Renanuya/optik-platform/drawings/sayfa-01.png

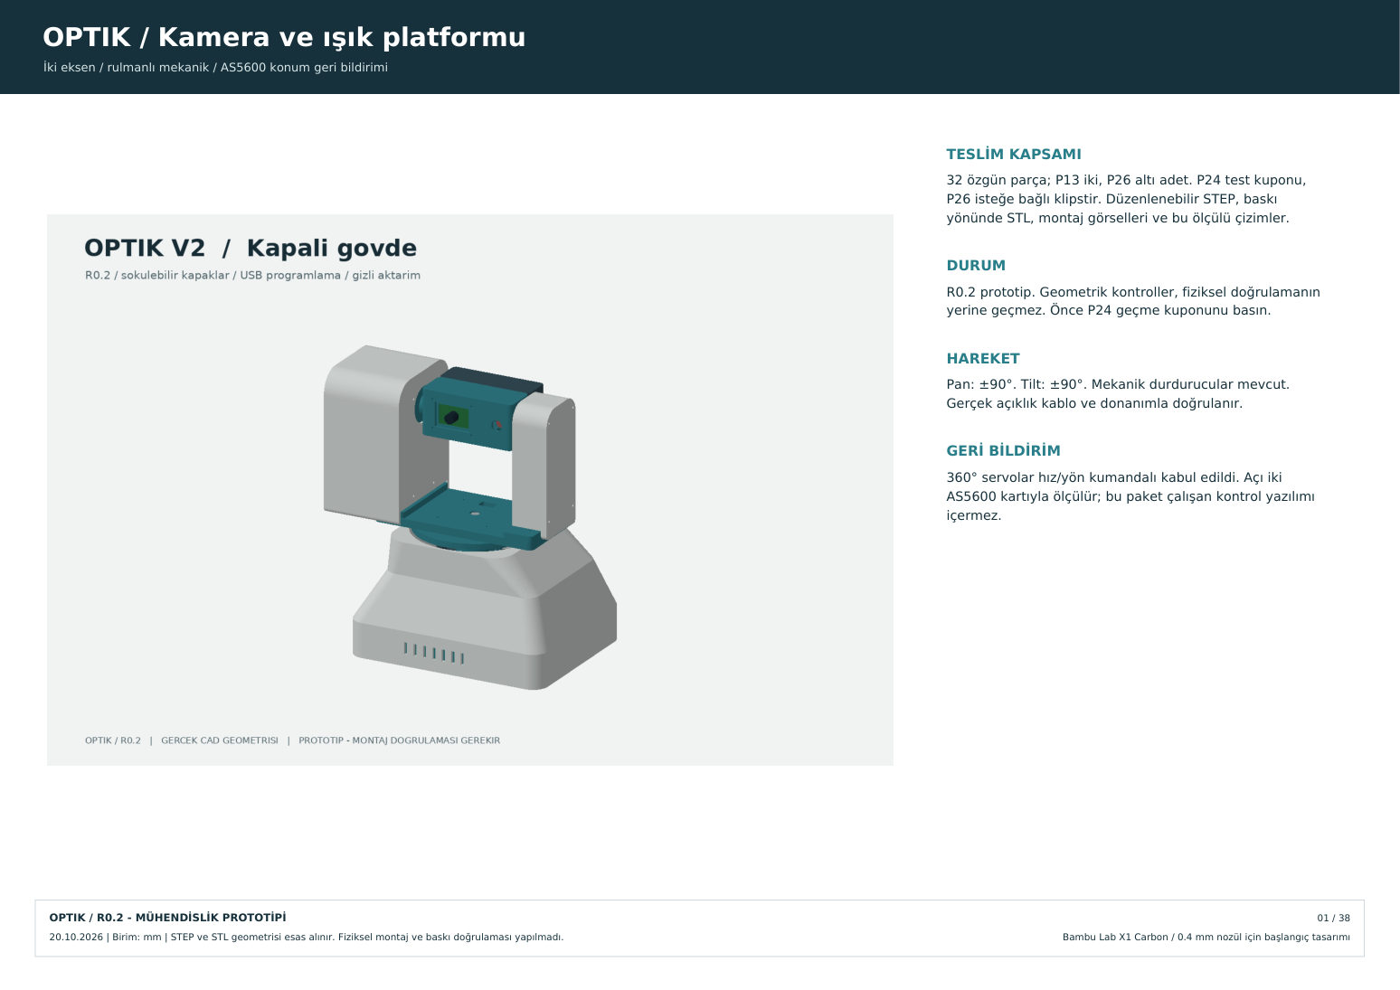
drawings/sayfa-01.png
