Renanuya/optik-platform/drawings/sayfa-02.png

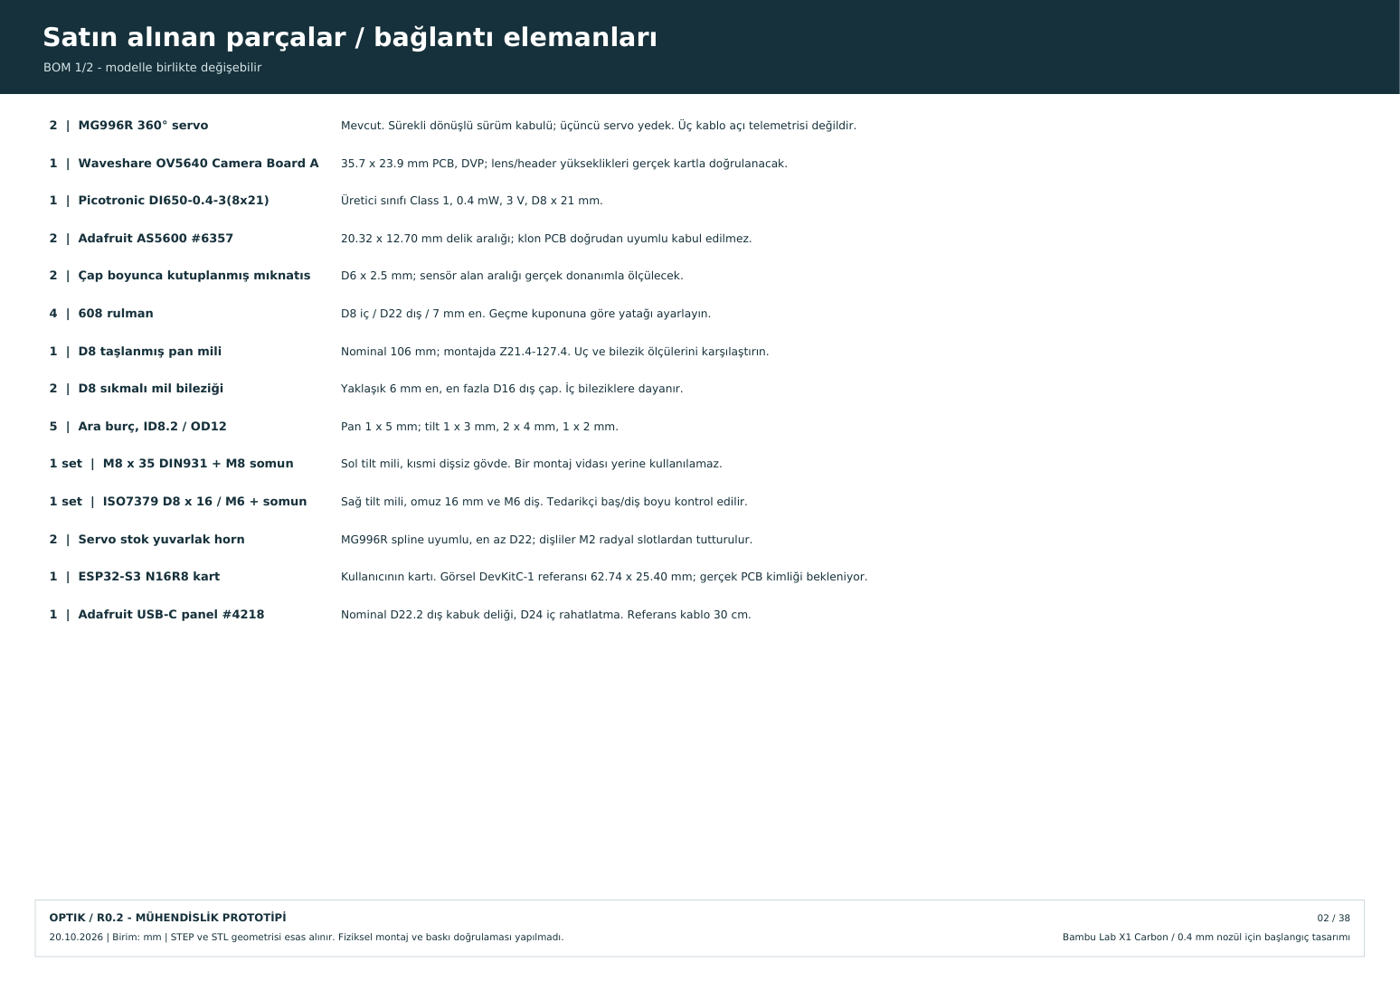
drawings/sayfa-02.png
