Renanuya/optik-platform/drawings/sayfa-03.png

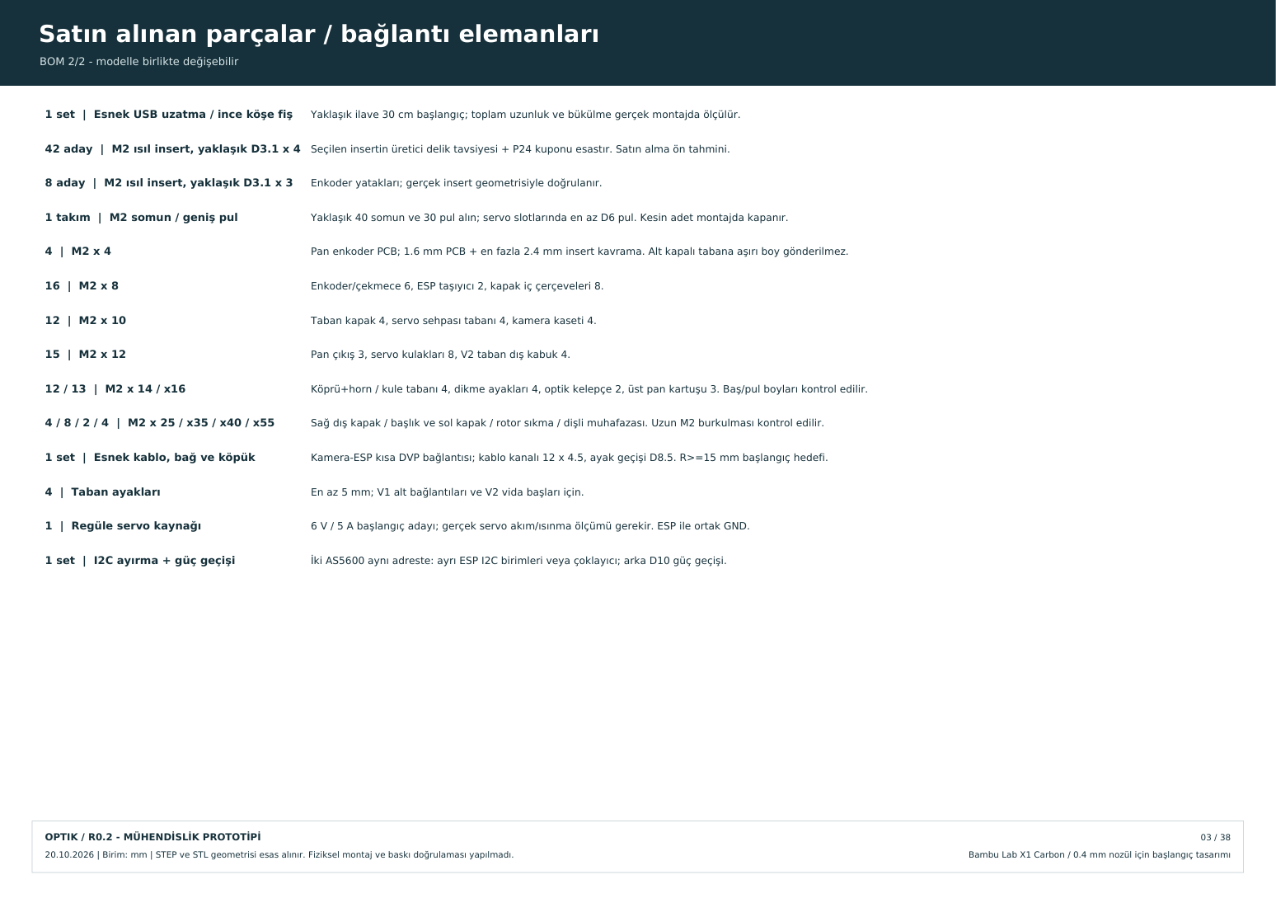
drawings/sayfa-03.png
