Renanuya/optik-platform/drawings/sayfa-04.png

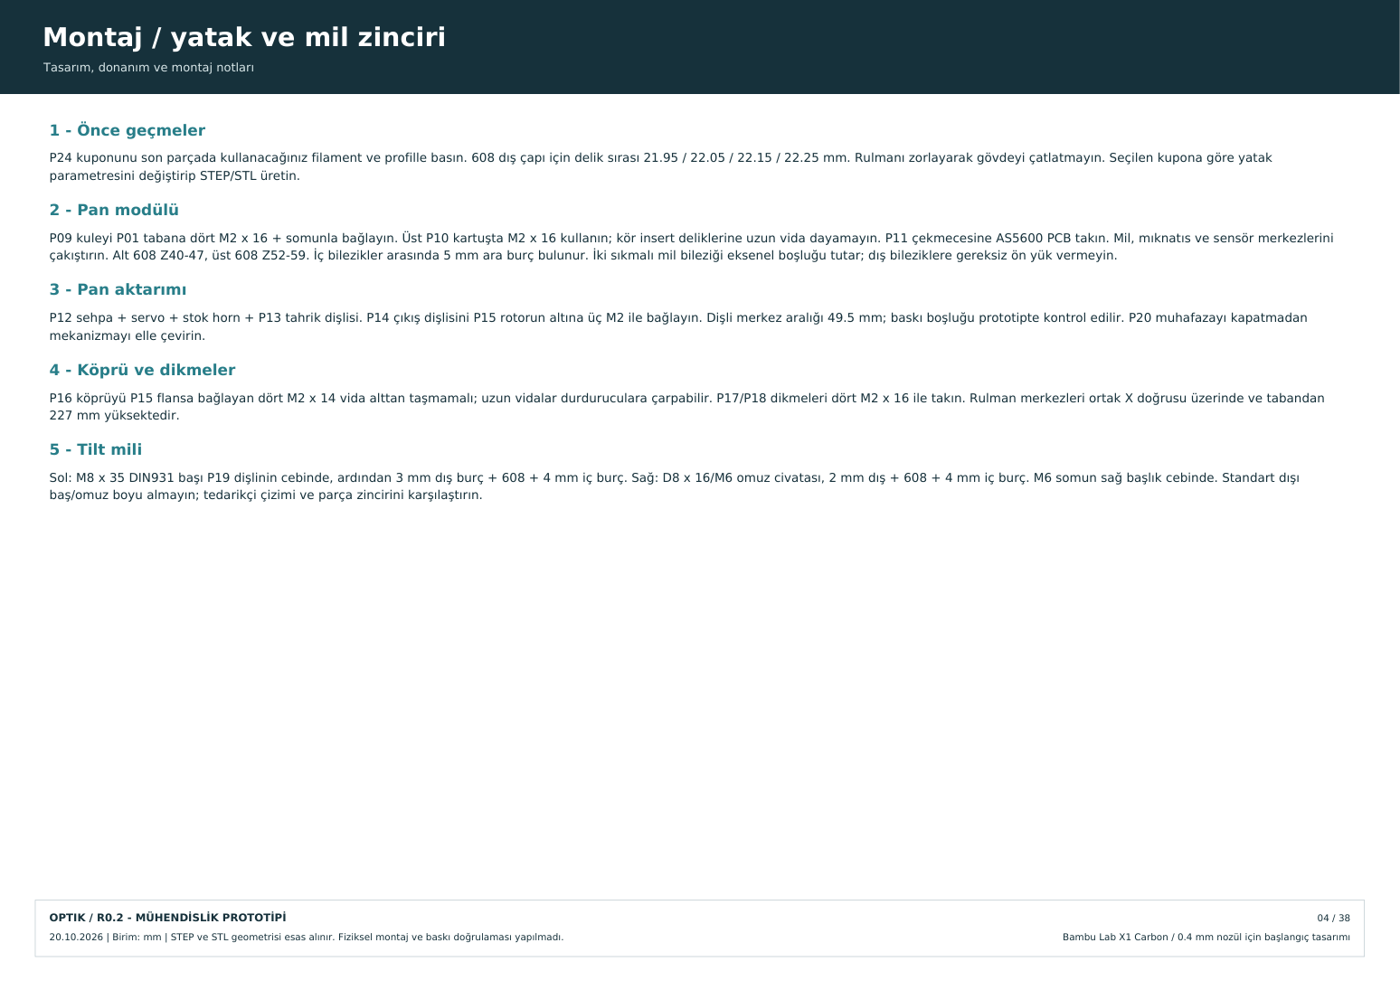
drawings/sayfa-04.png
