Renanuya/optik-platform/drawings/sayfa-05.png

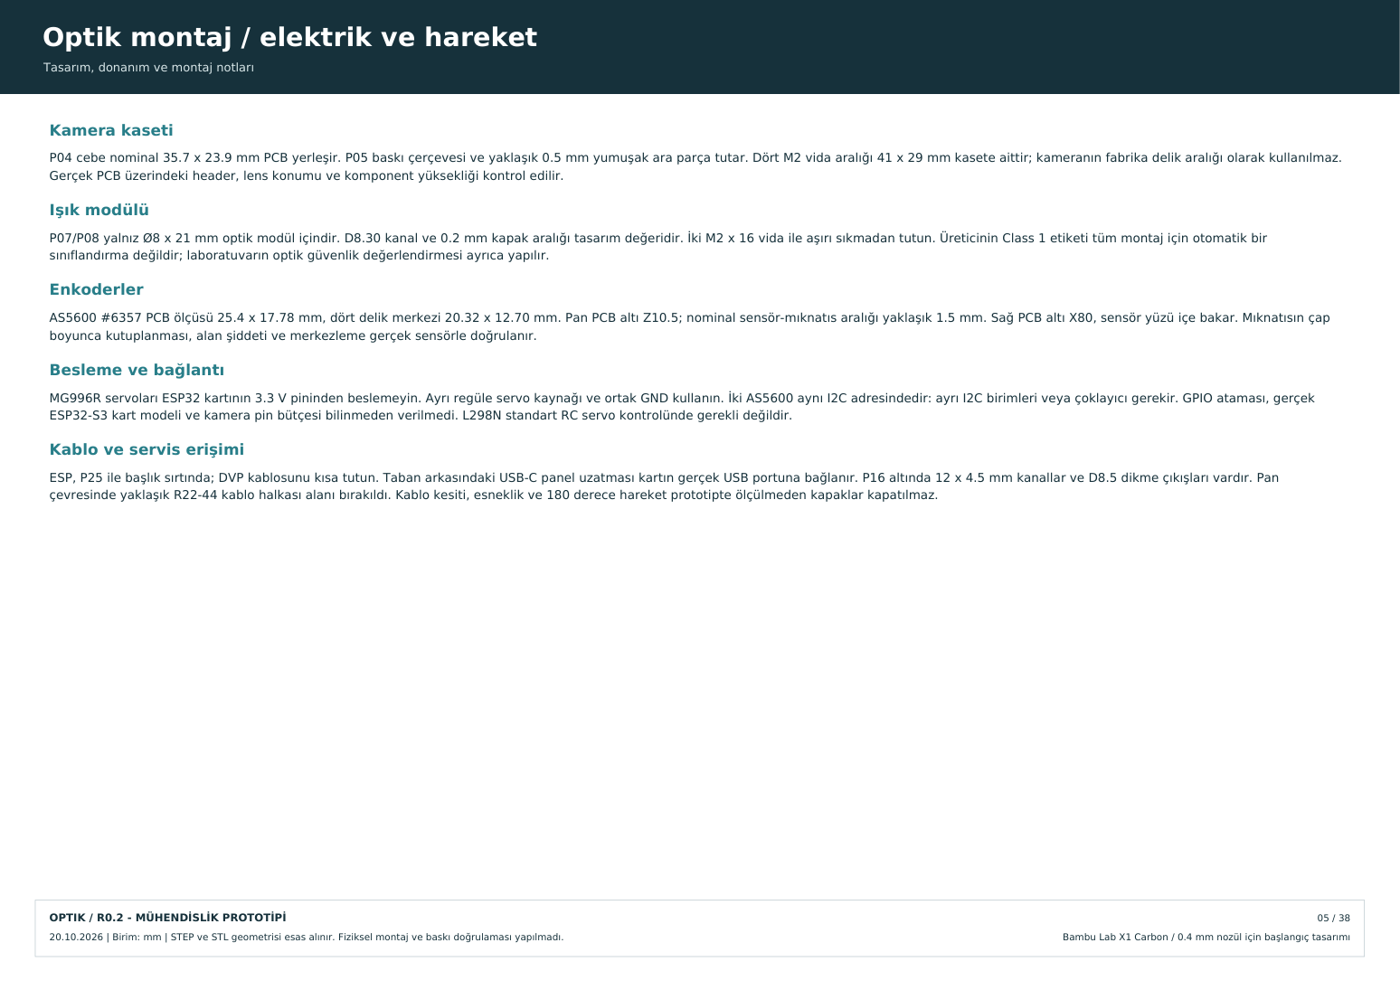
drawings/sayfa-05.png
