Renanuya/optik-platform/drawings/sayfa-06.png

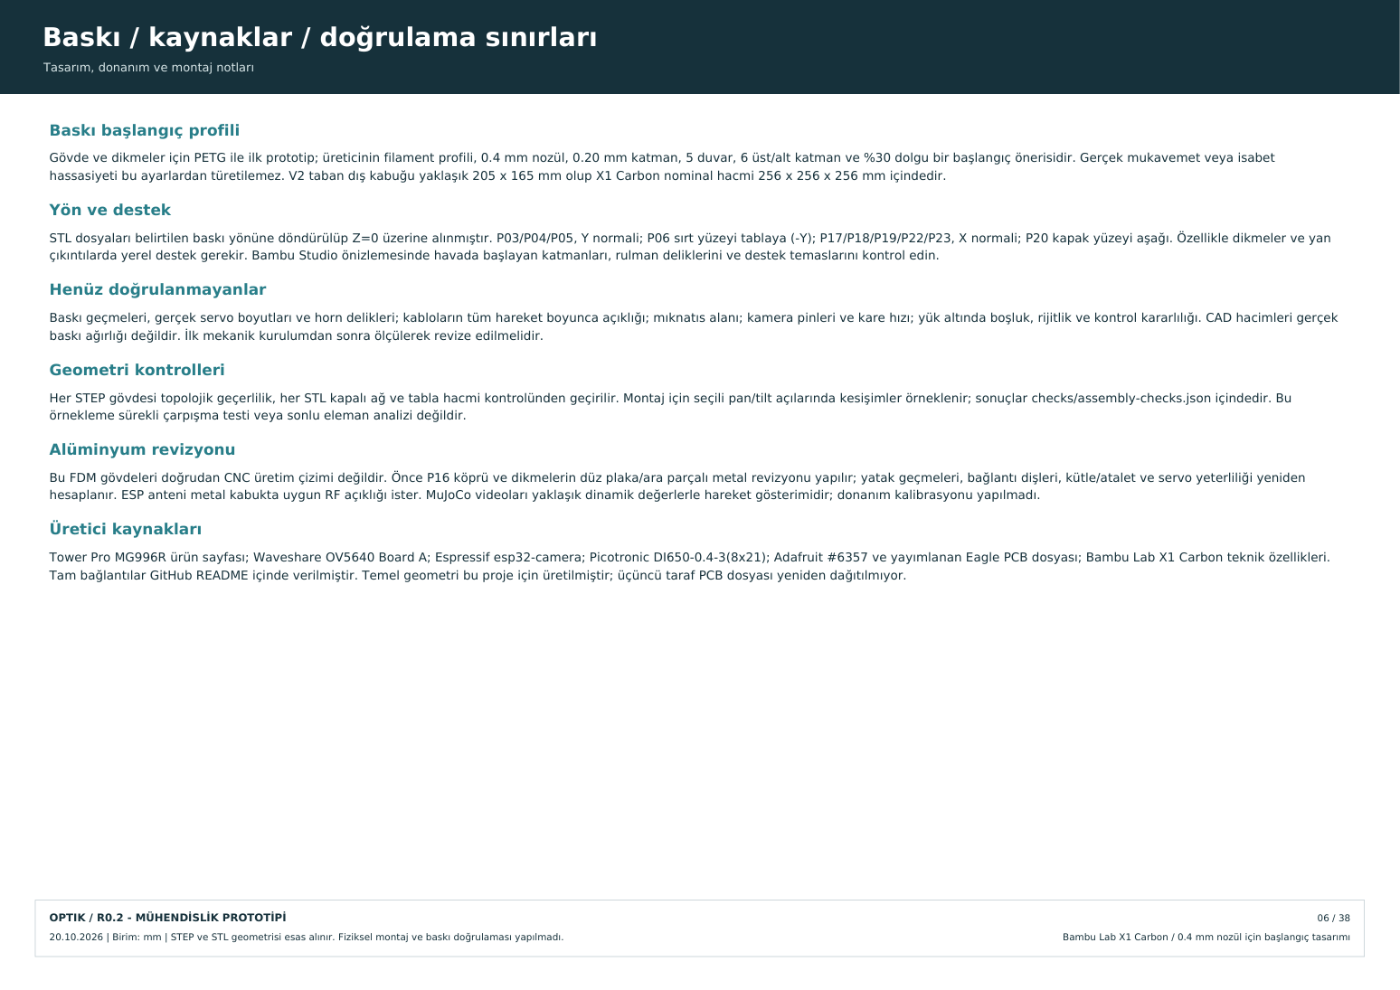
drawings/sayfa-06.png
