Renanuya/optik-platform/drawings/sayfa-07.png

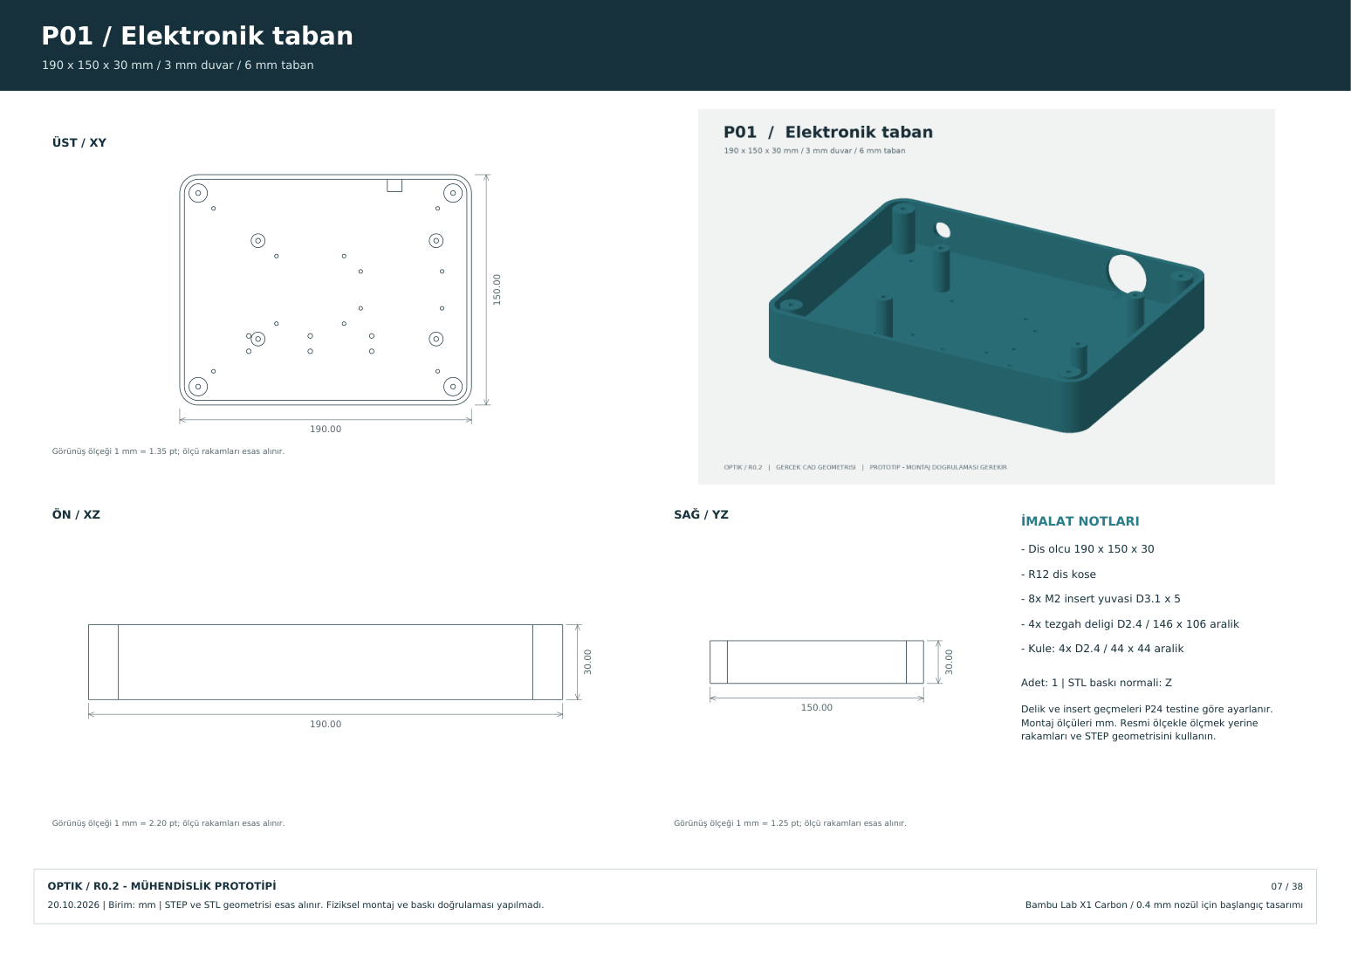
drawings/sayfa-07.png
