Renanuya/optik-platform/drawings/sayfa-08.png

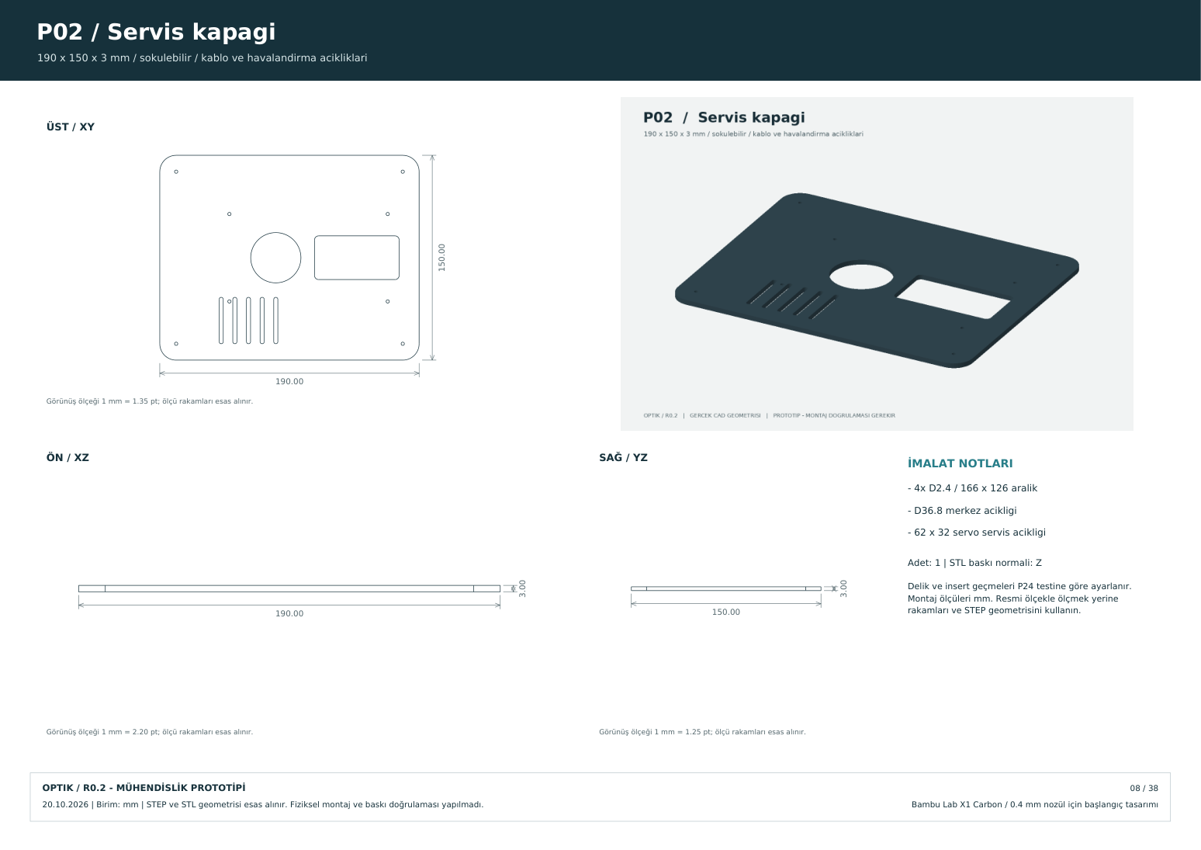
drawings/sayfa-08.png
