Renanuya/optik-platform/drawings/sayfa-09.png

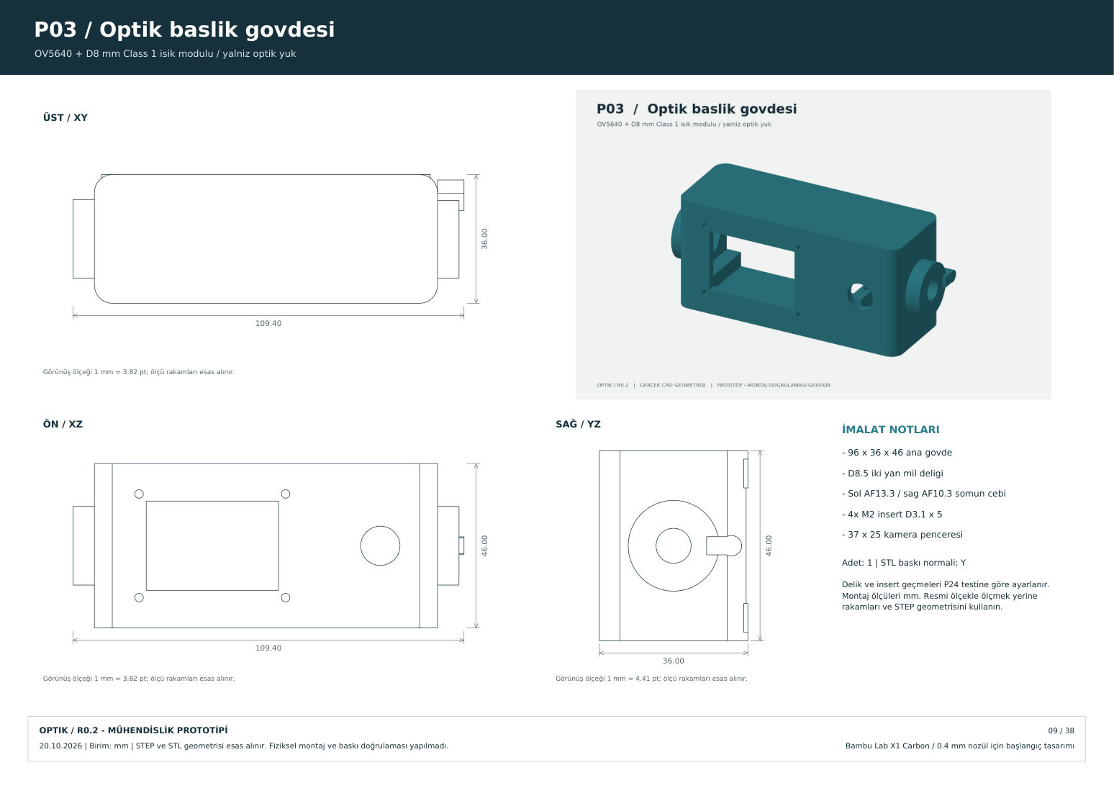
drawings/sayfa-09.png
