Renanuya/optik-platform/drawings/sayfa-10.png

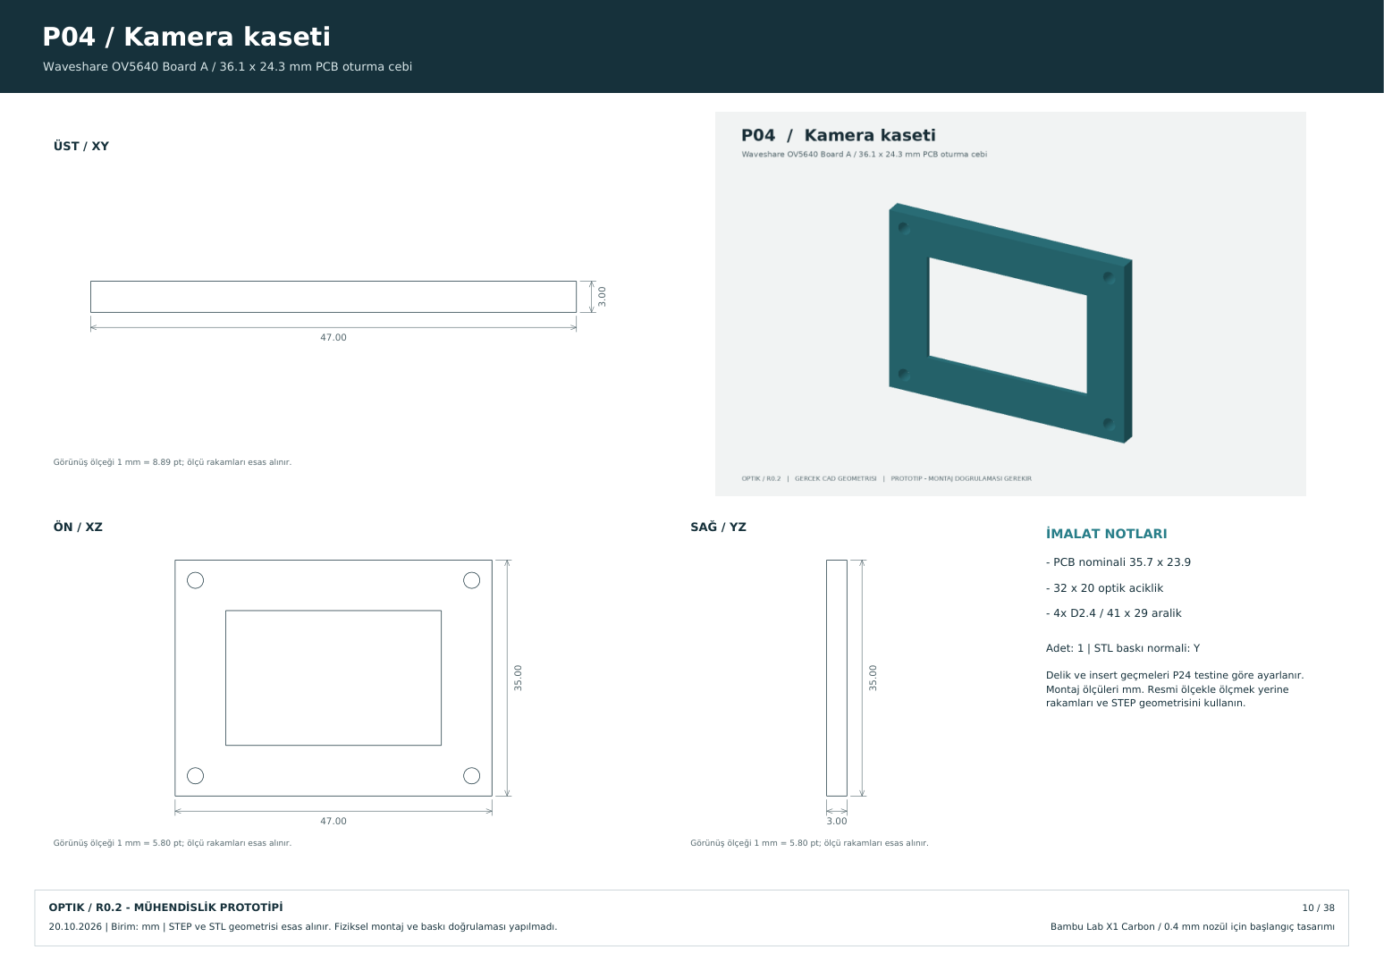
drawings/sayfa-10.png
