Renanuya/optik-platform/drawings/sayfa-11.png

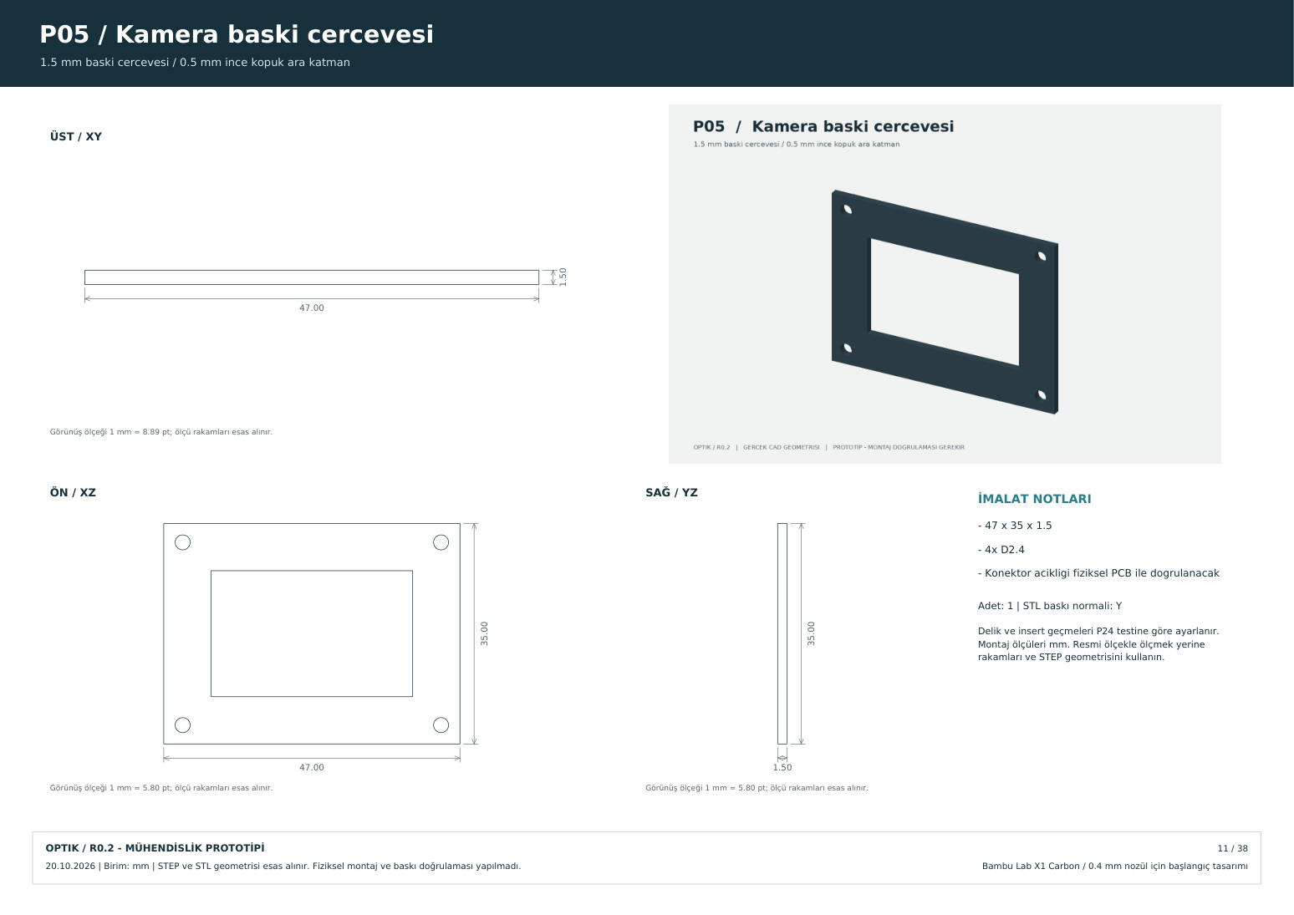
drawings/sayfa-11.png
