Renanuya/optik-platform/drawings/sayfa-12.png

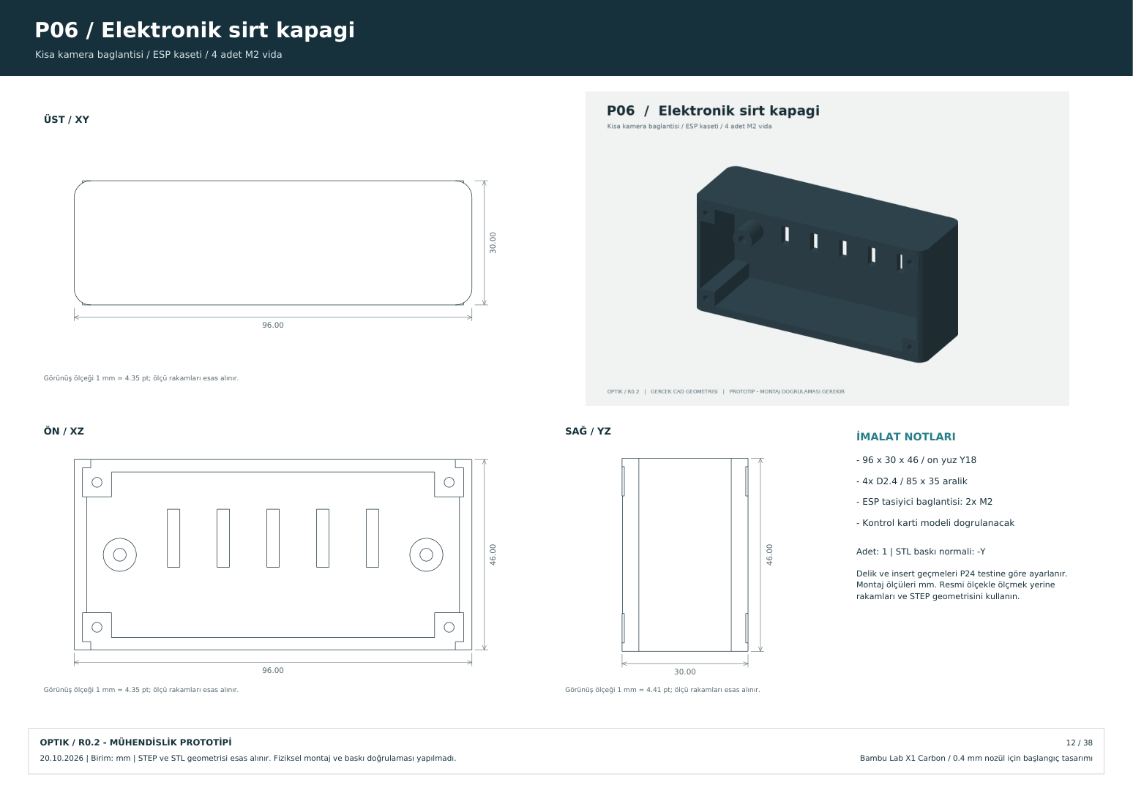
drawings/sayfa-12.png
