Renanuya/optik-platform/drawings/sayfa-13.png

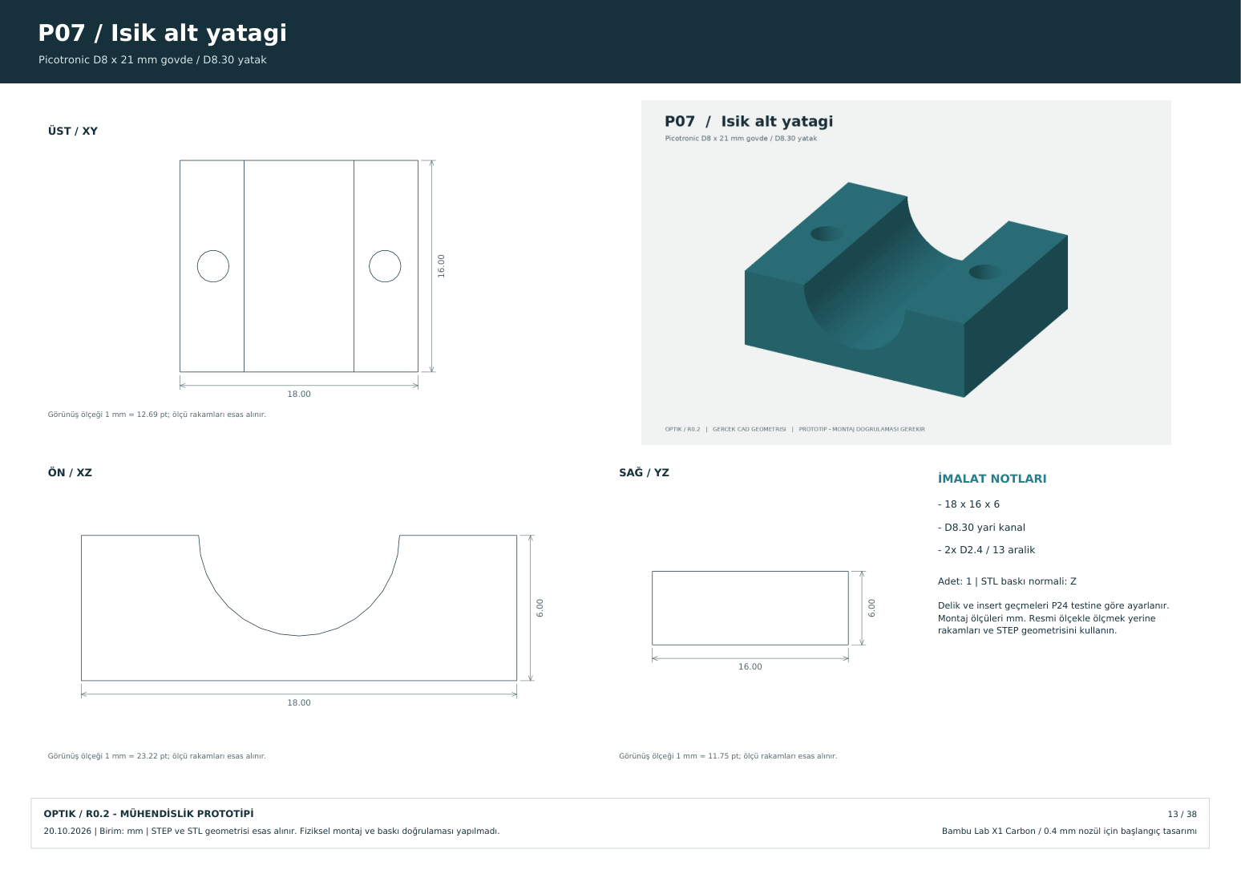
drawings/sayfa-13.png
