Renanuya/optik-platform/drawings/sayfa-14.png

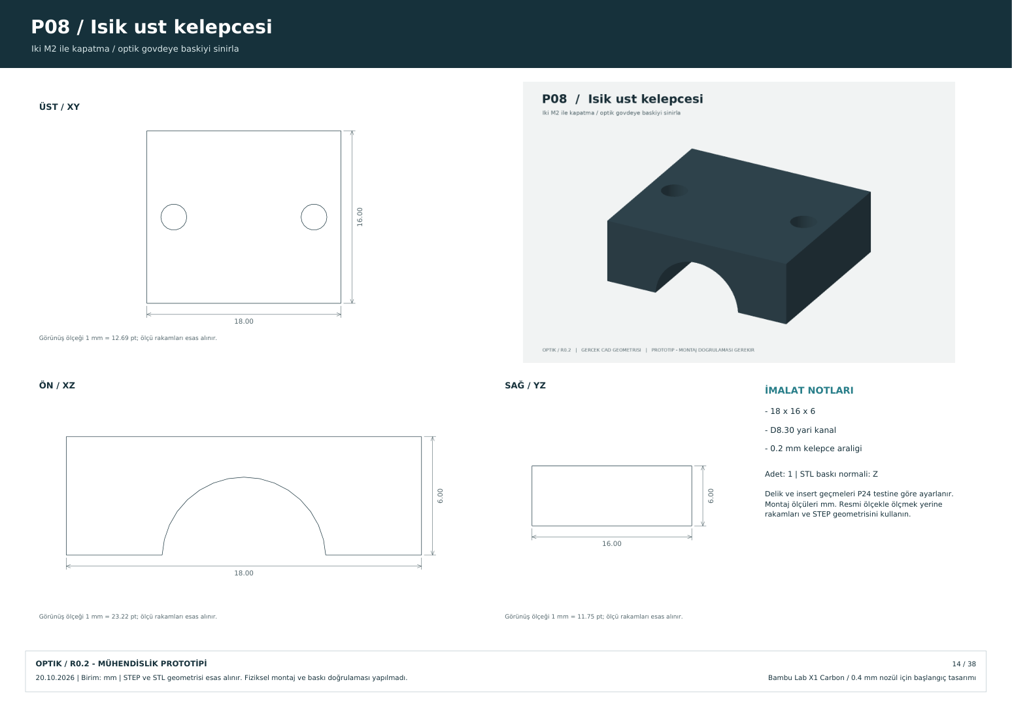
drawings/sayfa-14.png
