Renanuya/optik-platform/drawings/sayfa-15.png

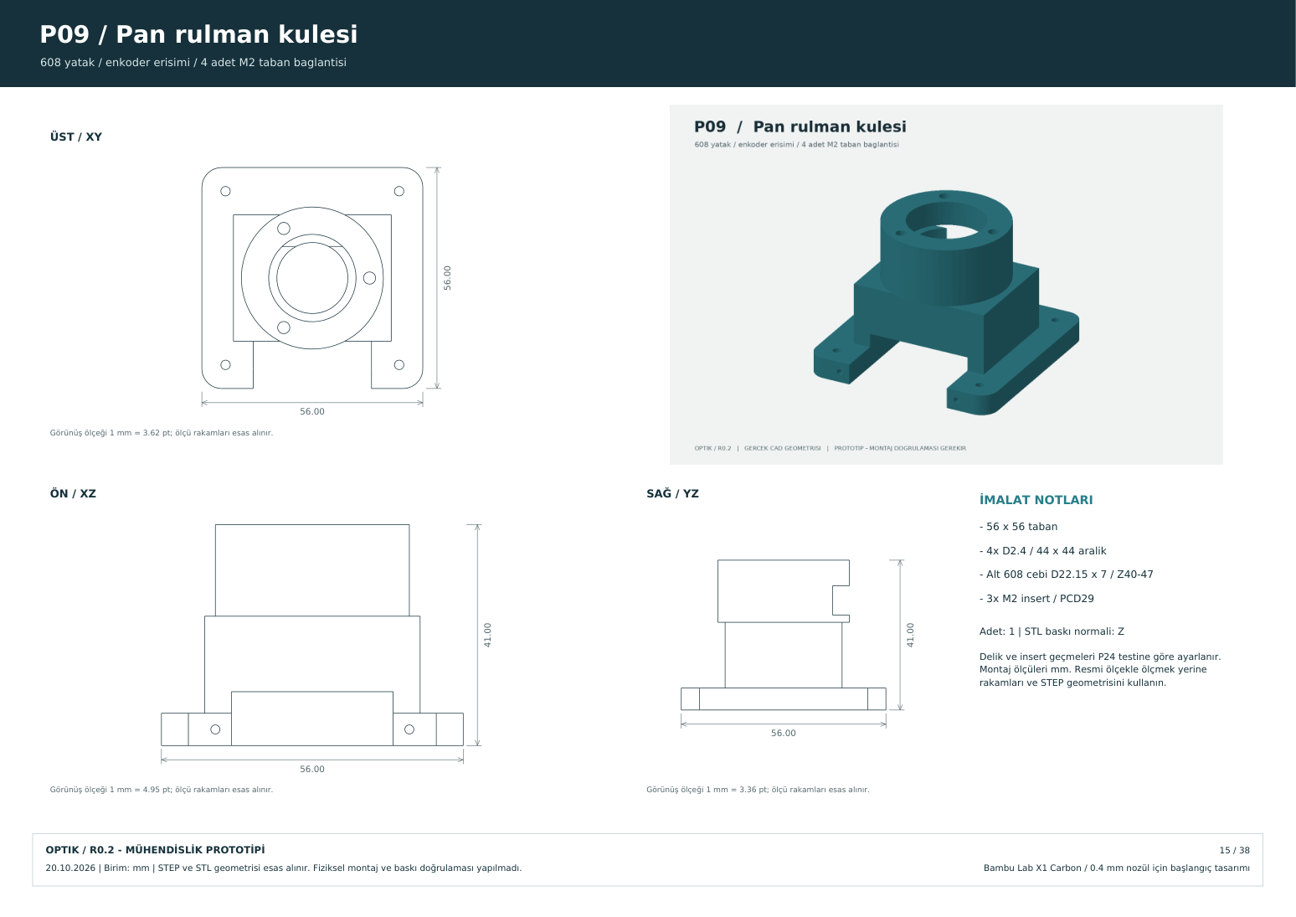
drawings/sayfa-15.png
