Renanuya/optik-platform/drawings/sayfa-16.png

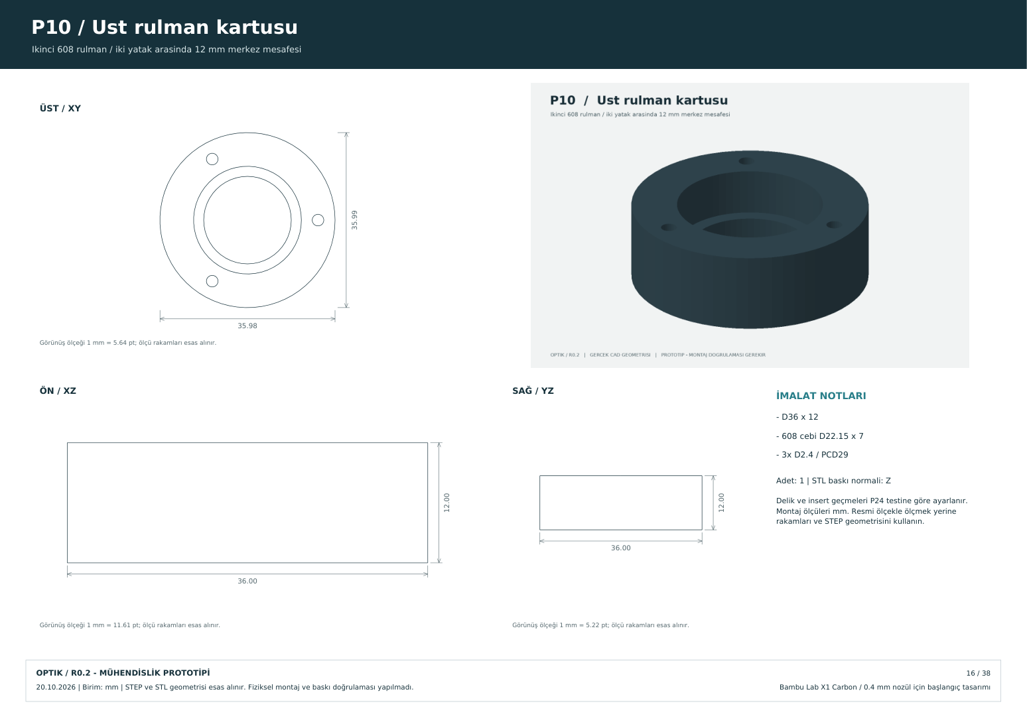
drawings/sayfa-16.png
