Renanuya/optik-platform/drawings/sayfa-17.png

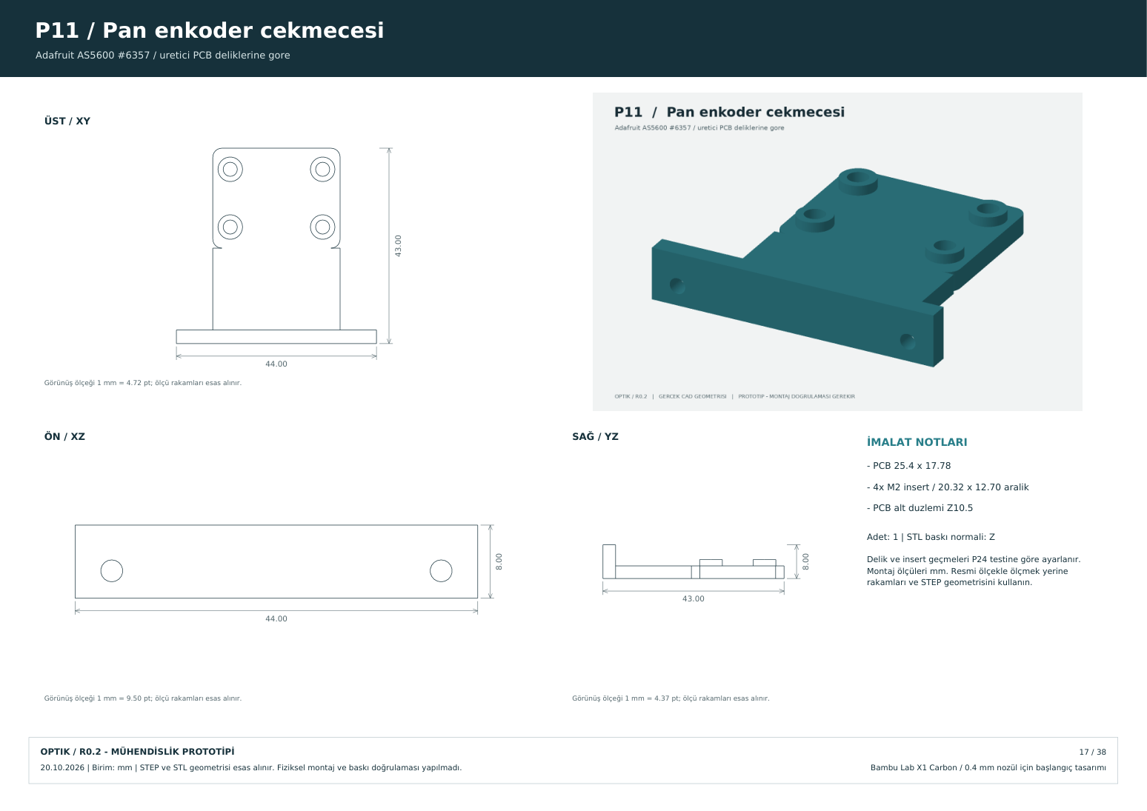
drawings/sayfa-17.png
