Renanuya/optik-platform/drawings/sayfa-18.png

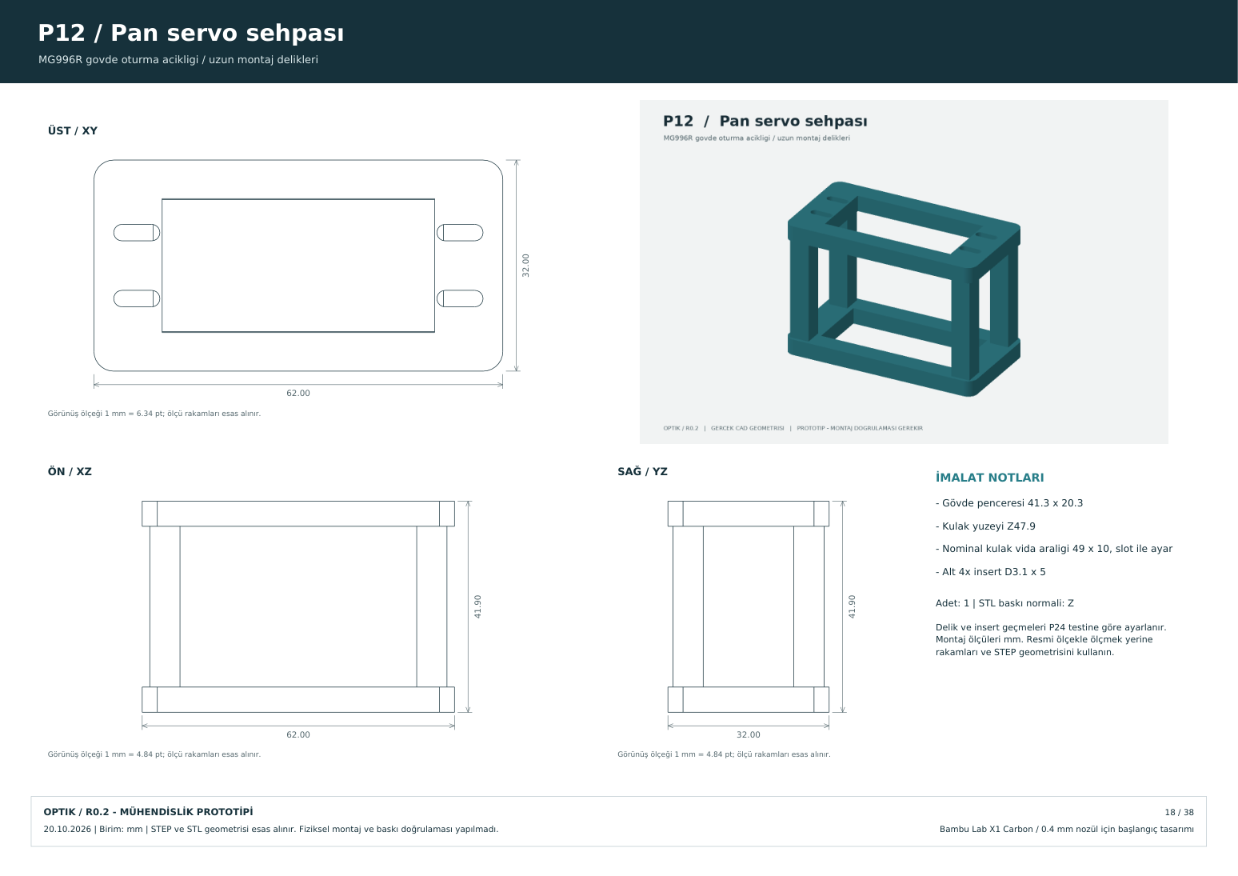
drawings/sayfa-18.png
