Renanuya/optik-platform/drawings/sayfa-19.png

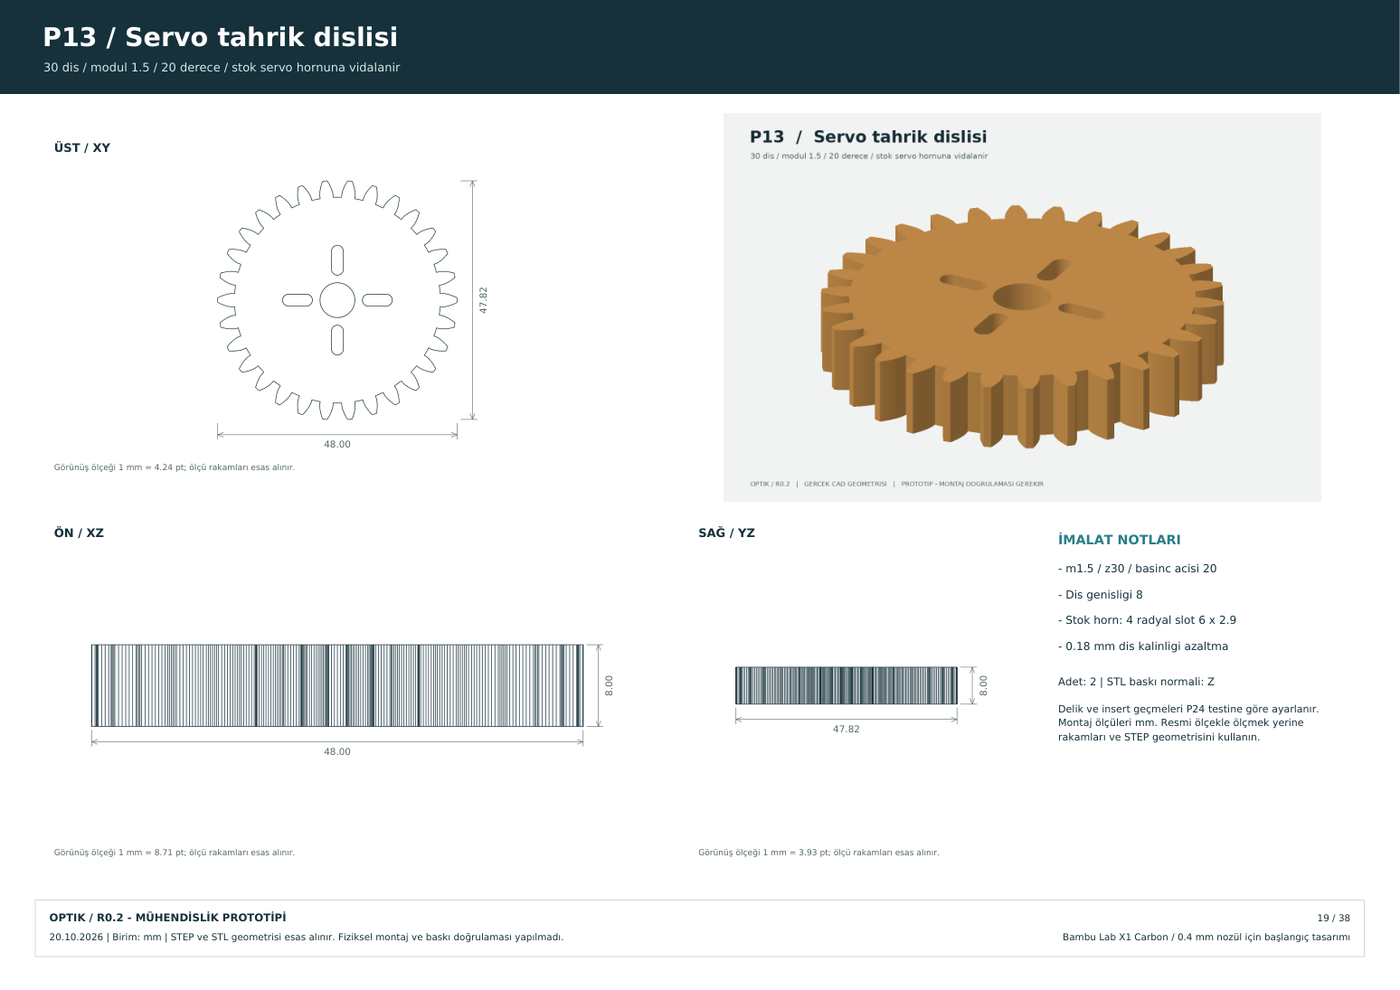
drawings/sayfa-19.png
