Renanuya/optik-platform/drawings/sayfa-21.png

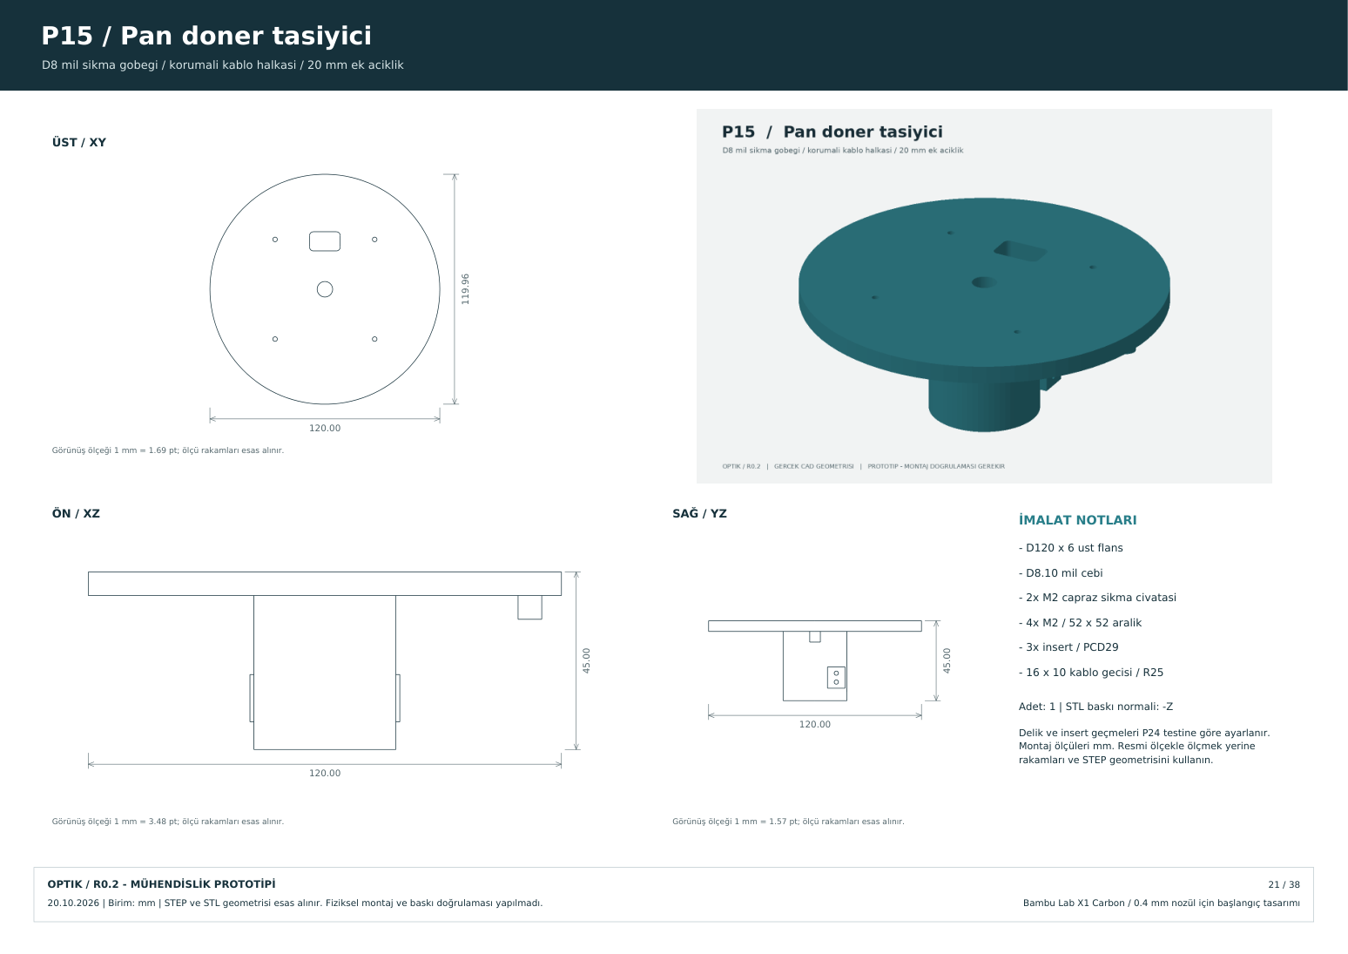
drawings/sayfa-21.png
