Renanuya/optik-platform/drawings/sayfa-22.png

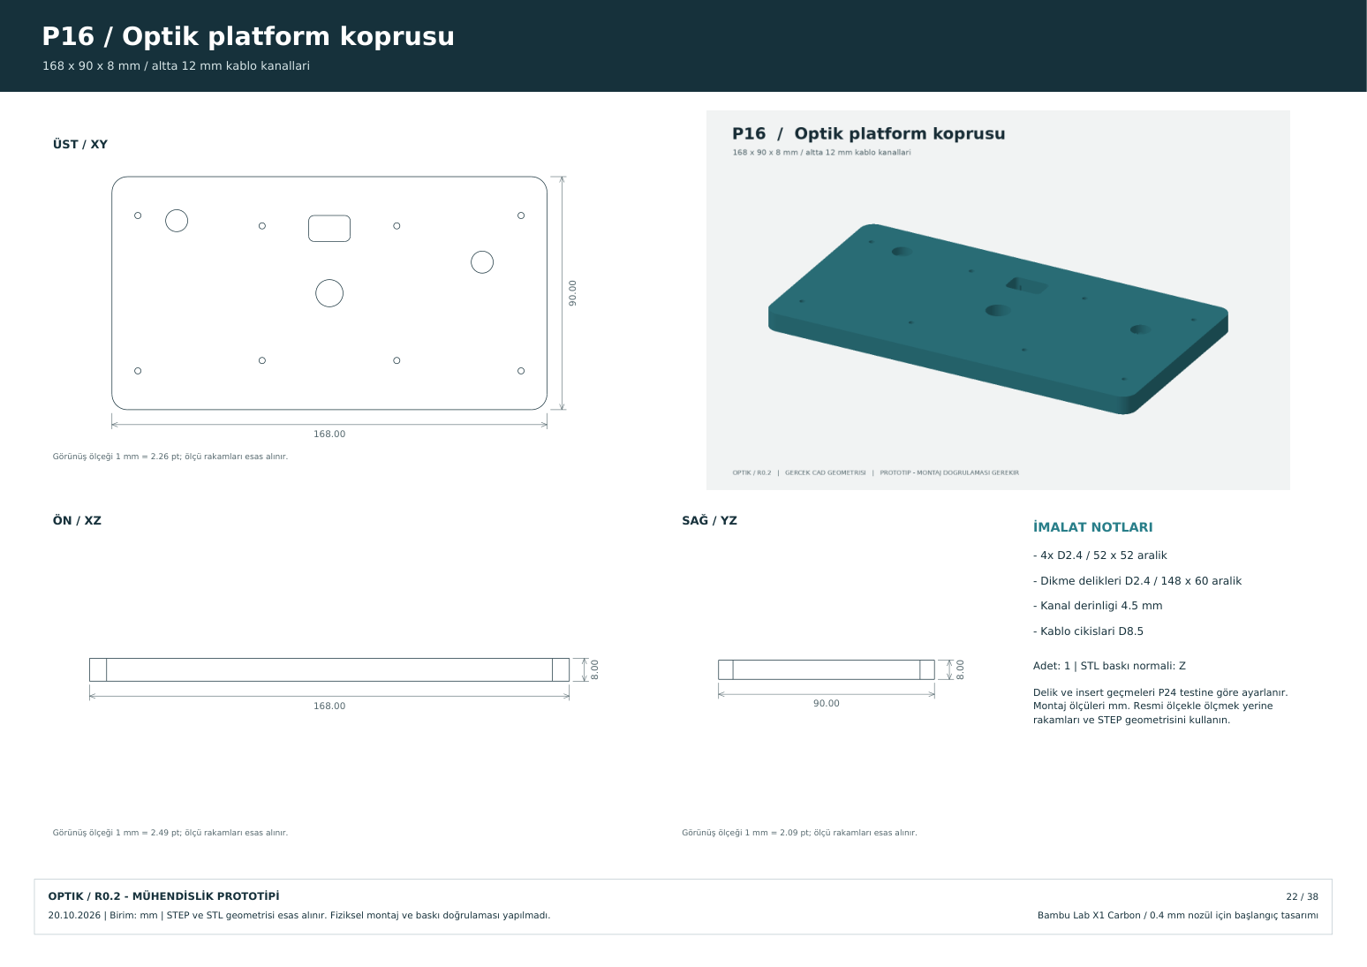
drawings/sayfa-22.png
