Renanuya/optik-platform/drawings/sayfa-23.png

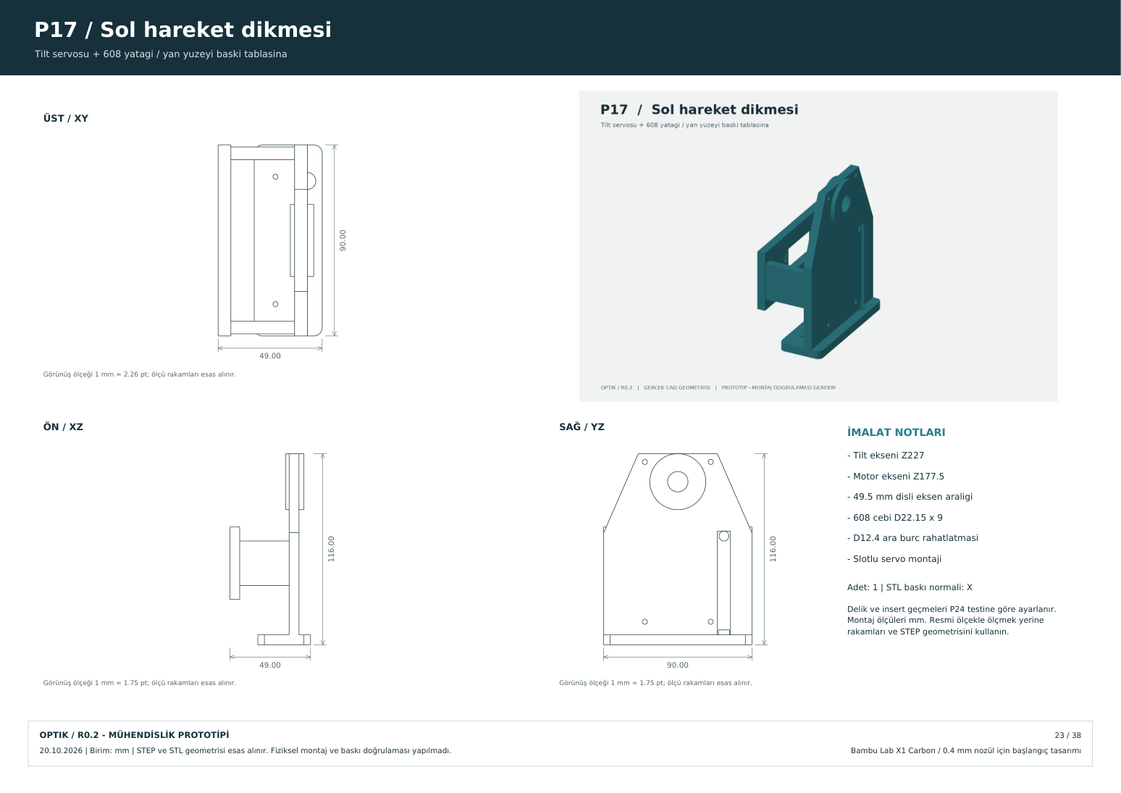
drawings/sayfa-23.png
