Renanuya/optik-platform/drawings/sayfa-24.png

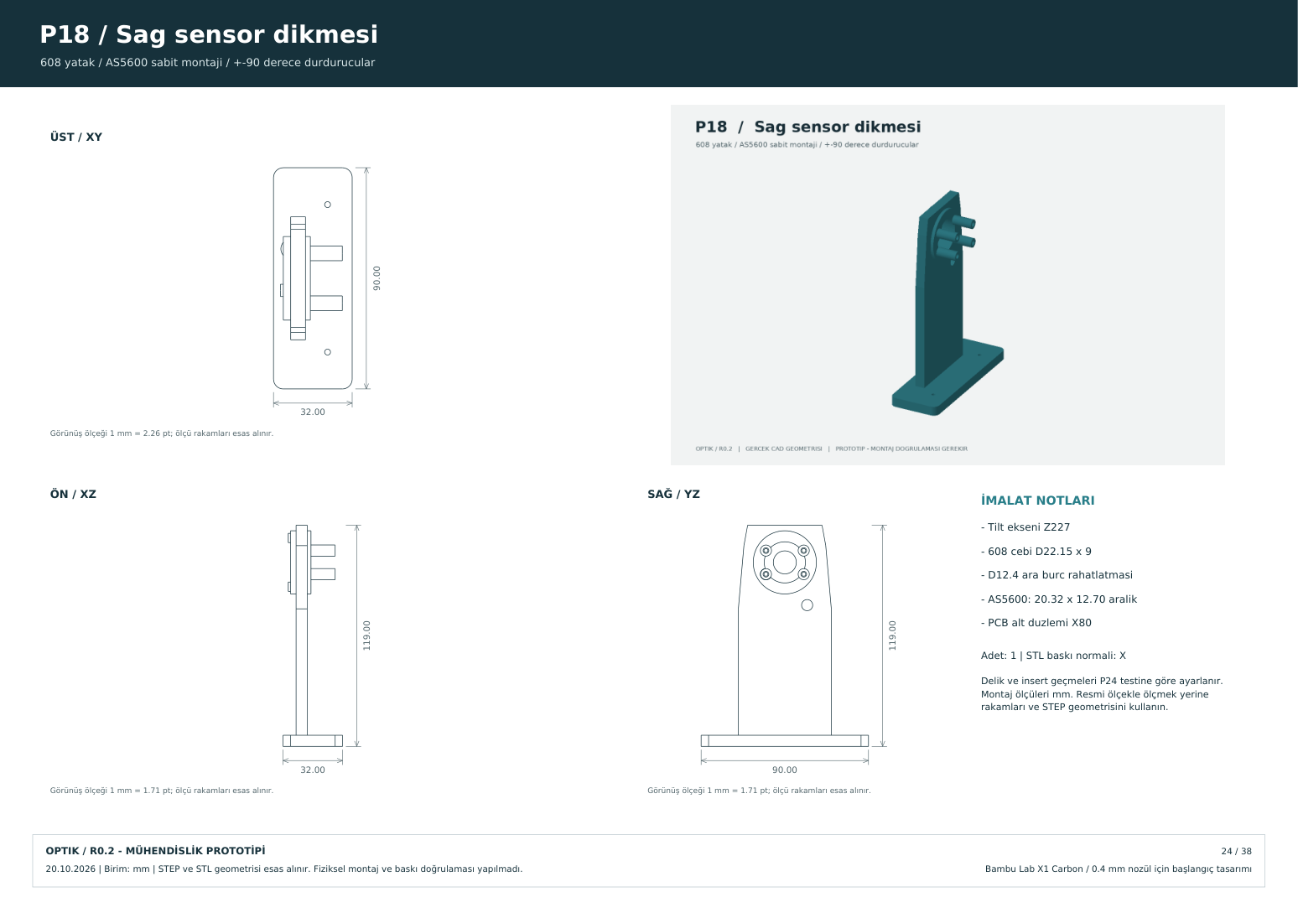
drawings/sayfa-24.png
