Renanuya/optik-platform/drawings/sayfa-25.png

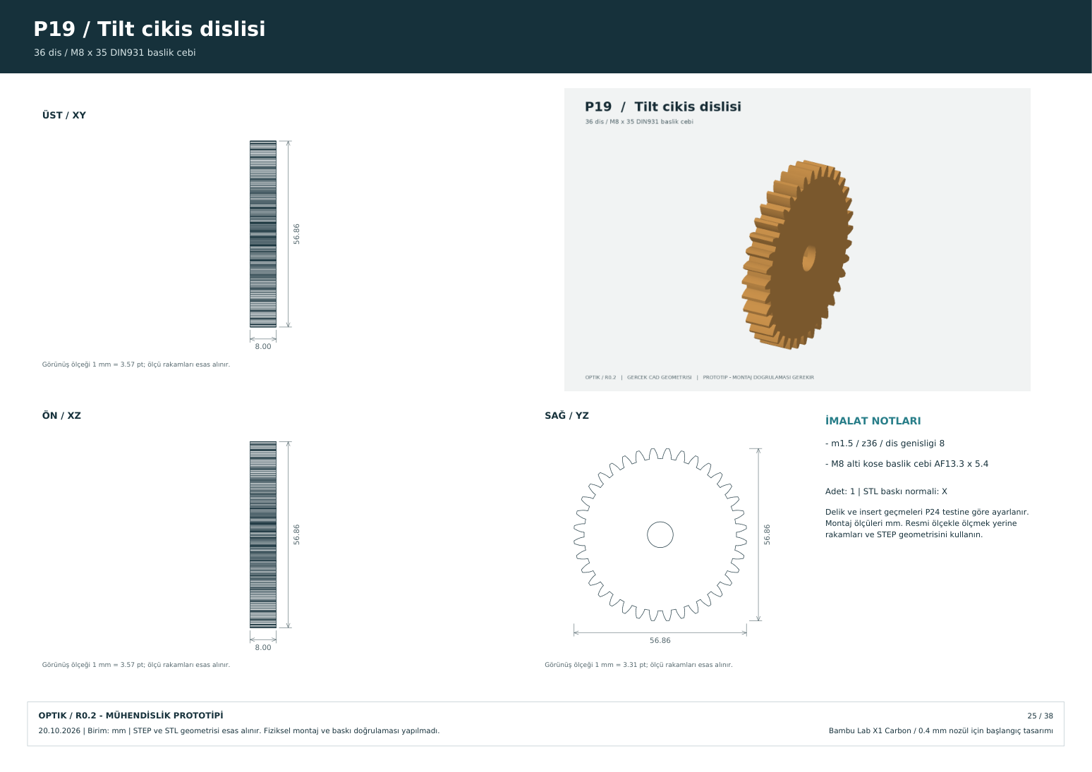
drawings/sayfa-25.png
