Renanuya/optik-platform/drawings/sayfa-26.png

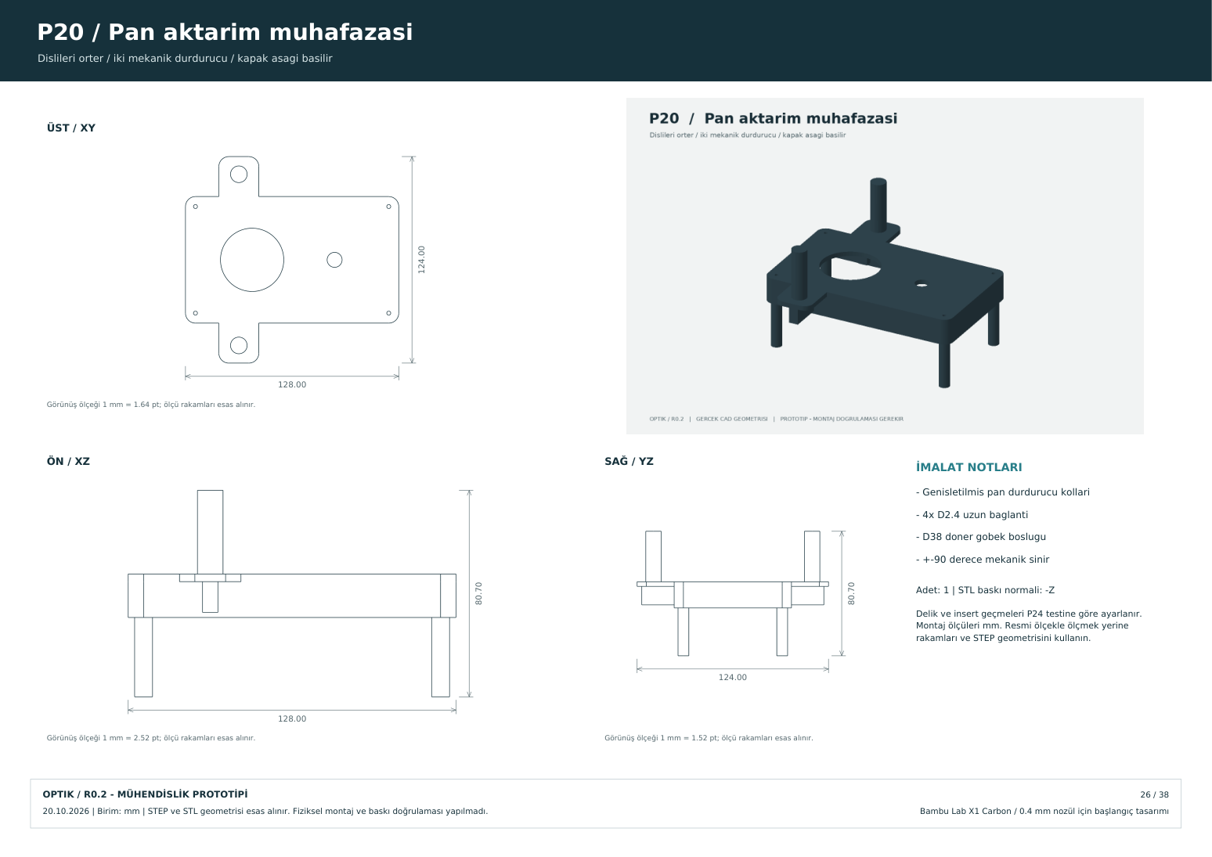
drawings/sayfa-26.png
