Renanuya/optik-platform/drawings/sayfa-27.png

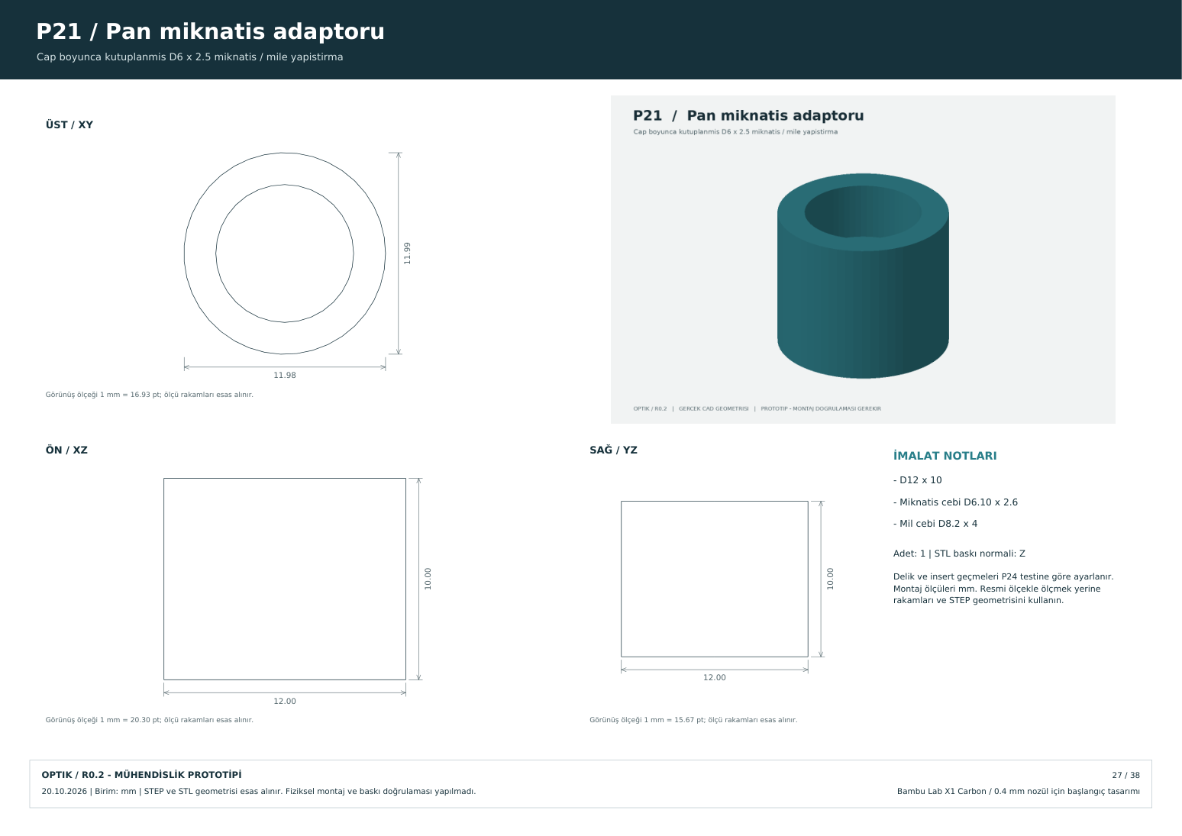
drawings/sayfa-27.png
