Renanuya/optik-platform/drawings/sayfa-30.png

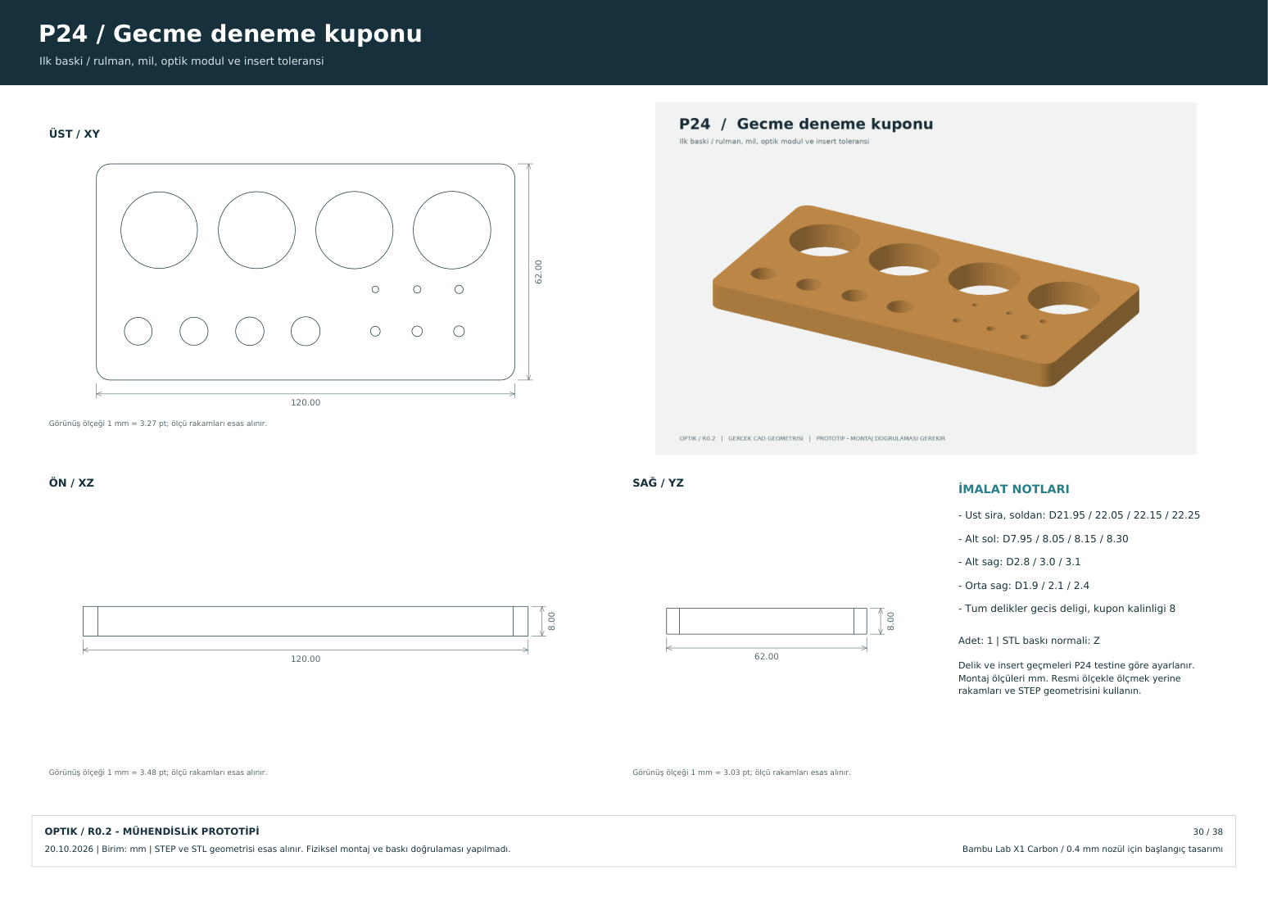
drawings/sayfa-30.png
