Renanuya/optik-platform/drawings/sayfa-31.png

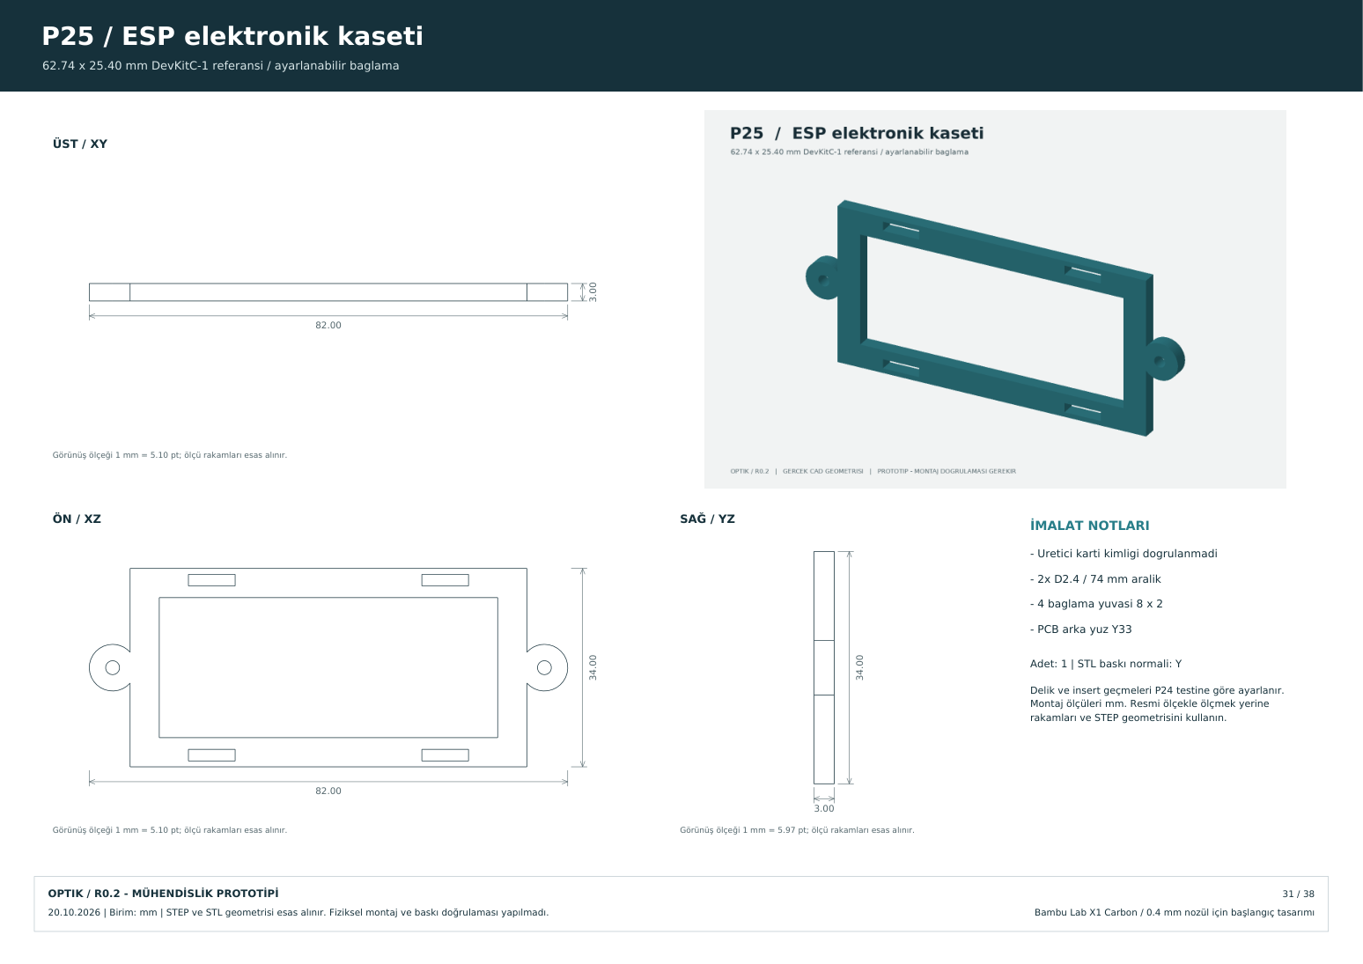
drawings/sayfa-31.png
