Renanuya/optik-platform/drawings/sayfa-32.png

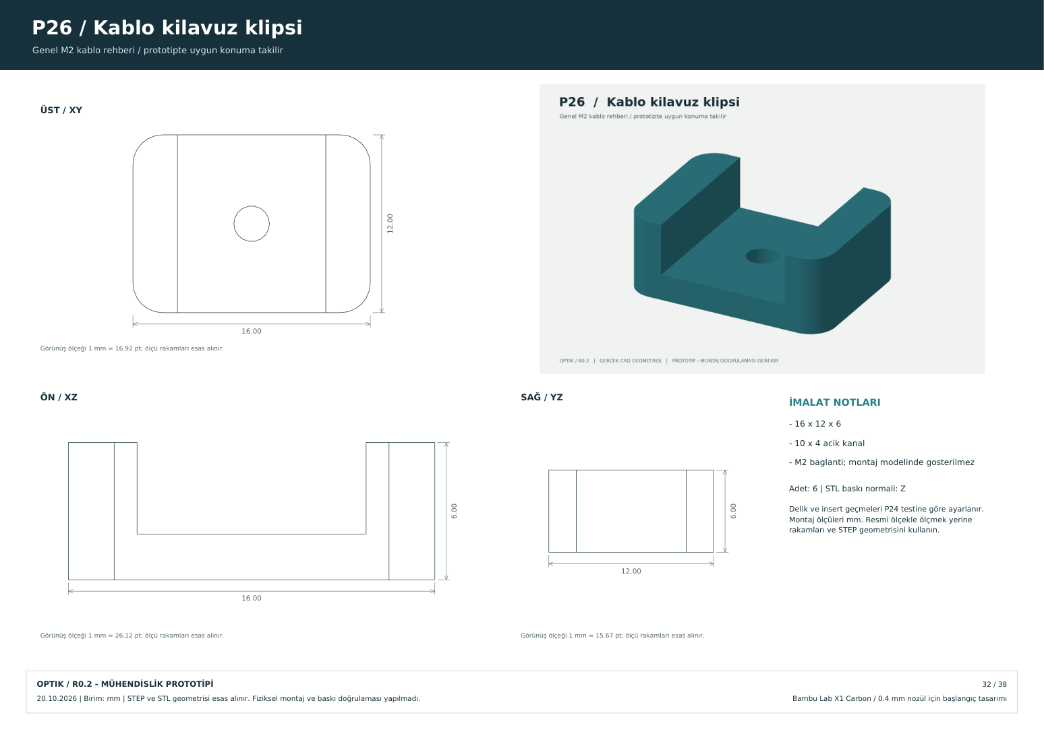
drawings/sayfa-32.png
