Renanuya/optik-platform/drawings/sayfa-33.png

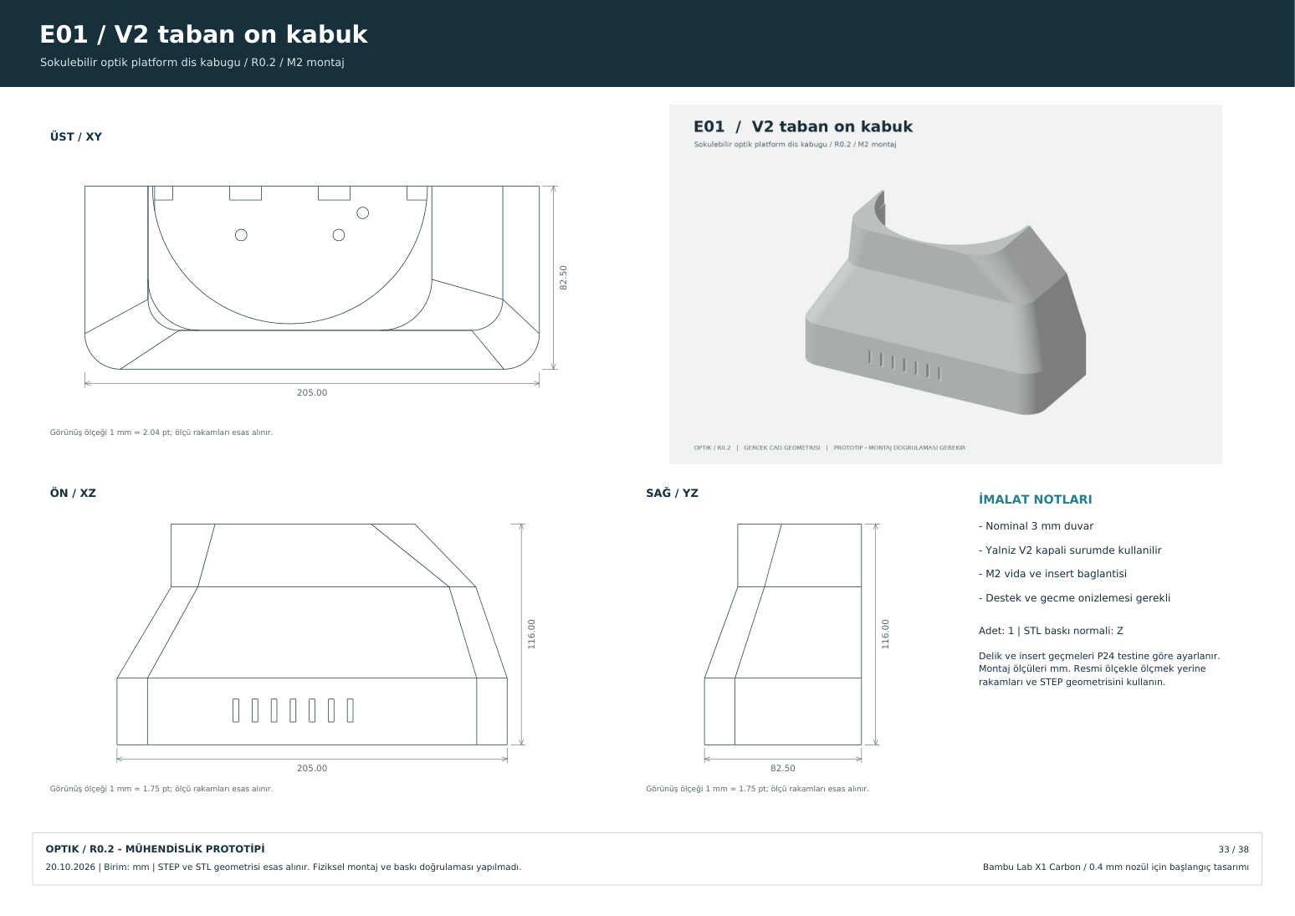
drawings/sayfa-33.png
