Renanuya/optik-platform/drawings/sayfa-34.png

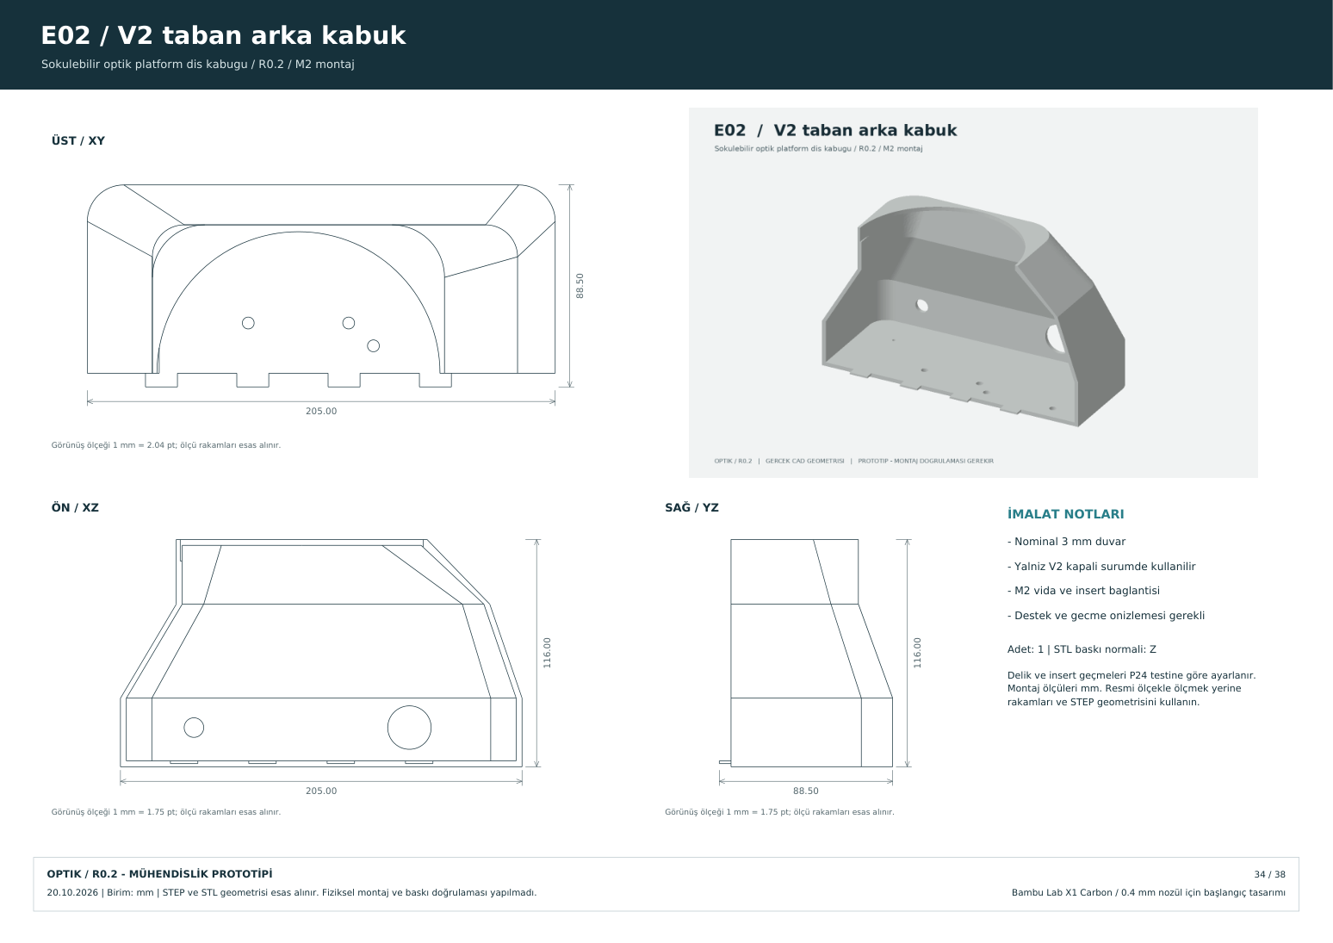
drawings/sayfa-34.png
