Renanuya/optik-platform/simulation/optik-v1-poster.png

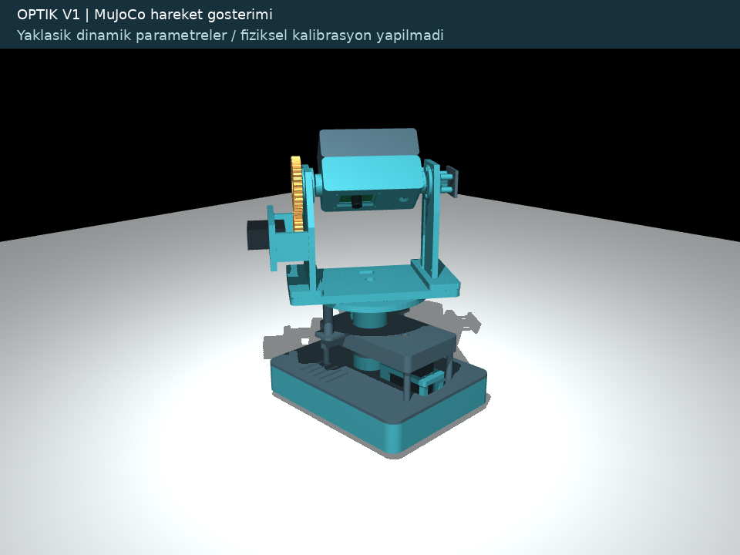
simulation/optik-v1-poster.png
