Renanuya/optik-platform/simulation/optik-v2-poster.png

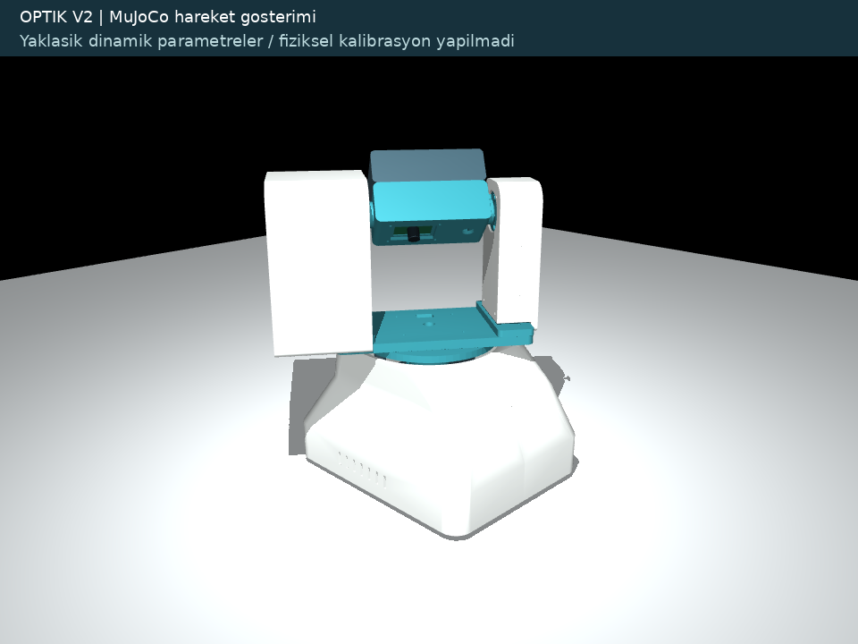
simulation/optik-v2-poster.png
