Renanuya/optik-platform/cad/P23.step

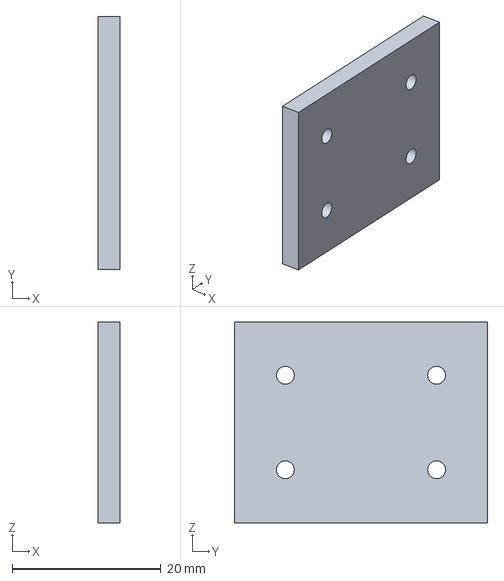
[picture p99: CAD file, 2026-10-20]
cad/P23.step
3.00 x 34.0 x 27.0 mm
