Renanuya/optik-platform/simulation/assets/P23.stl

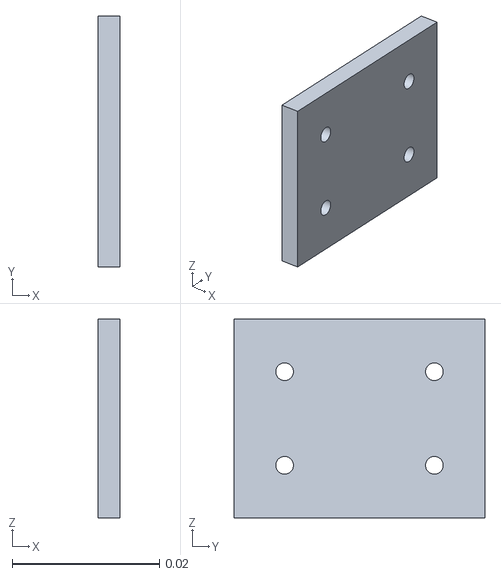
[picture p100: CAD file, 2026-10-20]
simulation/assets/P23.stl
0.003 x 0.034 x 0.027
