Renanuya/optik-platform/cad/P03.step

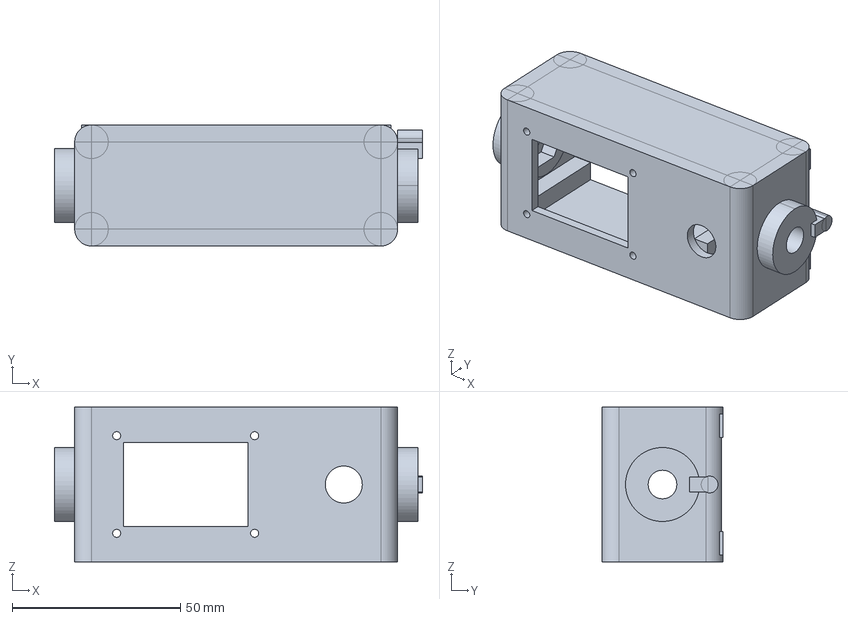
[picture p101: CAD file, 2026-10-20]
cad/P03.step
109.4 x 36.0 x 46.0 mm
