Renanuya/optik-platform/simulation/assets/P14.stl

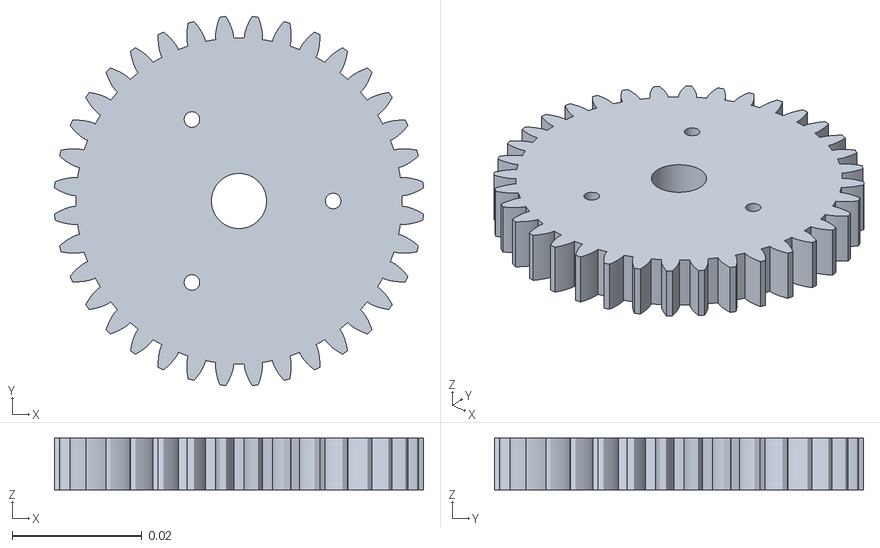
[picture p102: CAD file, 2026-10-20]
simulation/assets/P14.stl
0.0569 x 0.0569 x 0.008
