Renanuya/optik-platform/cad/P09.step

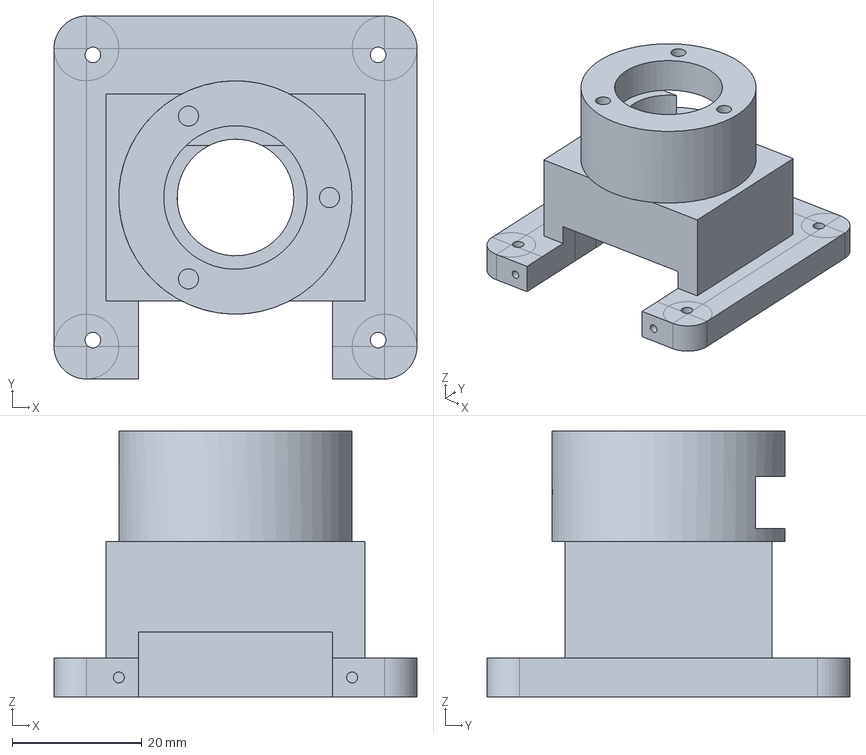
[picture p103: CAD file, 2026-10-20]
cad/P09.step
56.0 x 56.0 x 41.0 mm
