Renanuya/optik-platform/simulation/assets/P17.stl

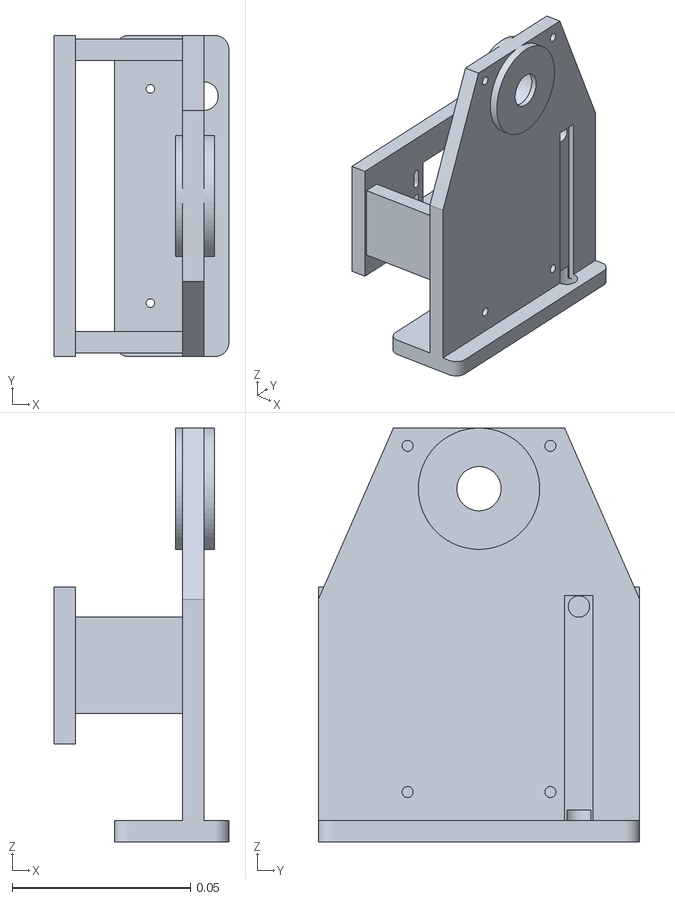
[picture p104: CAD file, 2026-10-20]
simulation/assets/P17.stl
0.049 x 0.09 x 0.116
