Renanuya/optik-platform/cad/P05.step

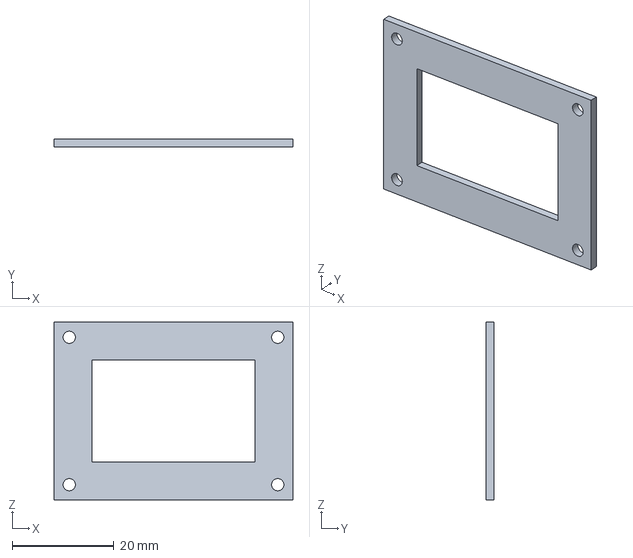
[picture p105: CAD file, 2026-10-20]
cad/P05.step
47.0 x 1.50 x 35.0 mm
