Renanuya/optik-platform/simulation/assets/P10.stl

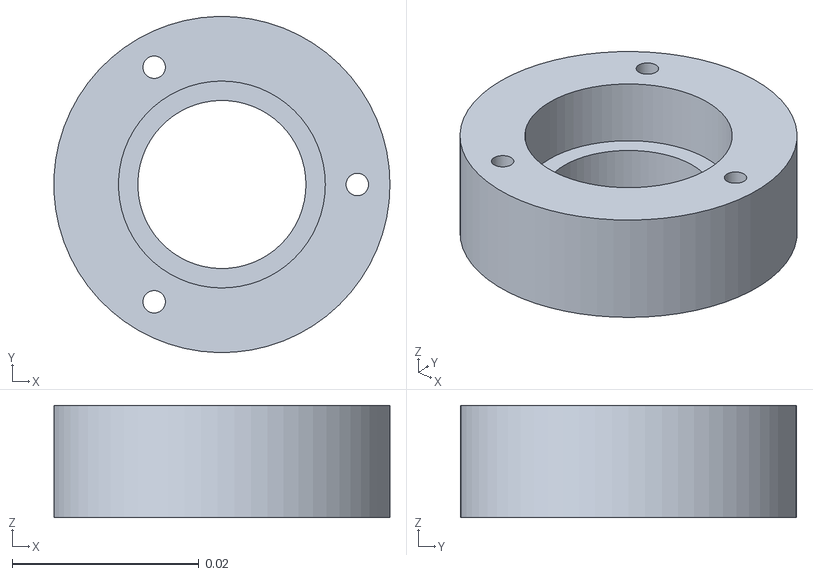
[picture p106: CAD file, 2026-10-20]
simulation/assets/P10.stl
0.036 x 0.036 x 0.012
