Renanuya/optik-platform/cad/P06.step

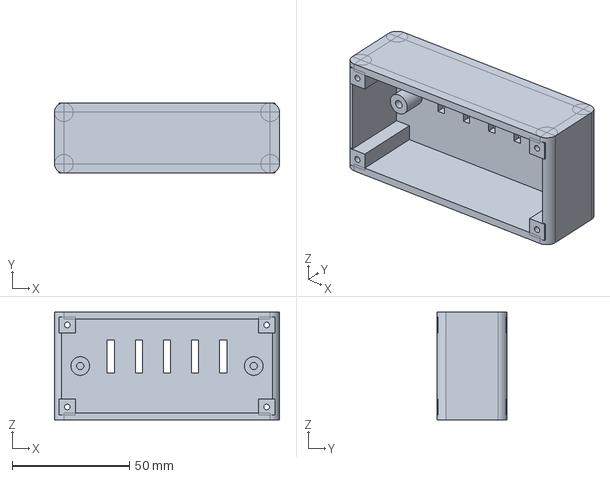
[picture p107: CAD file, 2026-10-20]
cad/P06.step
96.0 x 30.0 x 46.0 mm
