Renanuya/optik-platform/simulation/assets/P15.stl

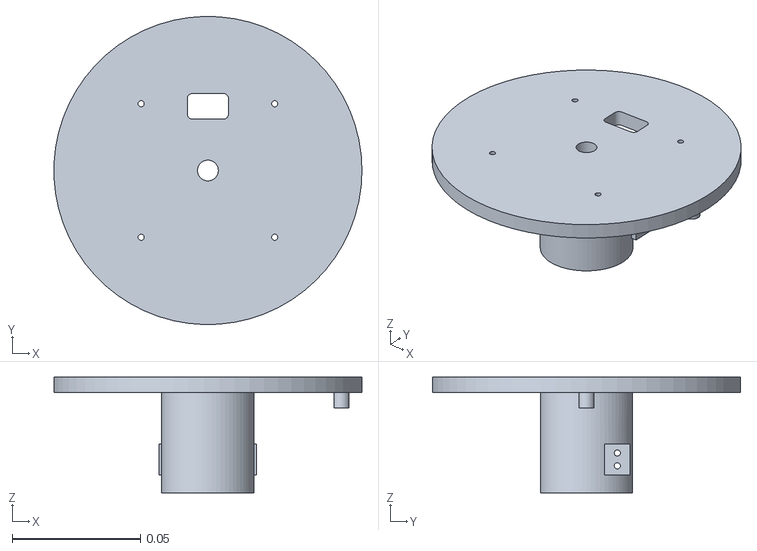
[picture p108: CAD file, 2026-10-20]
simulation/assets/P15.stl
0.12 x 0.12 x 0.045
