Renanuya/optik-platform/cad/P20.step

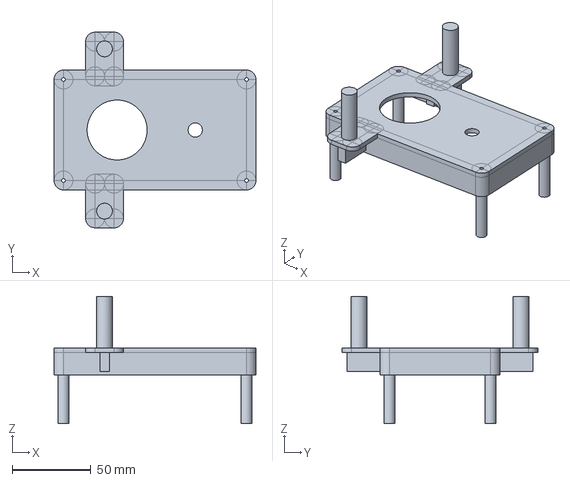
[picture p109: CAD file, 2026-10-20]
cad/P20.step
128.0 x 124.0 x 80.7 mm
