Renanuya/optik-platform/simulation/assets/E04.stl

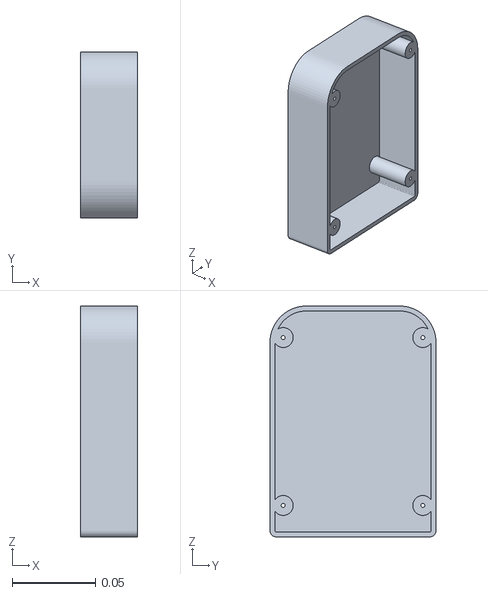
[picture p110: CAD file, 2026-10-20]
simulation/assets/E04.stl
0.034 x 0.1 x 0.139
