Renanuya/optik-platform/cad/P08.step

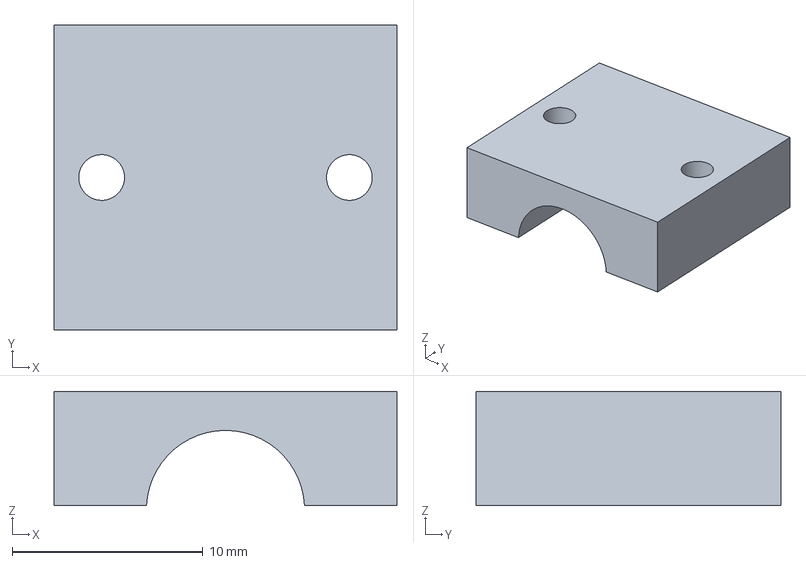
[picture p111: CAD file, 2026-10-20]
cad/P08.step
18.0 x 16.0 x 6.00 mm
