Renanuya/optik-platform/simulation/assets/E01.stl

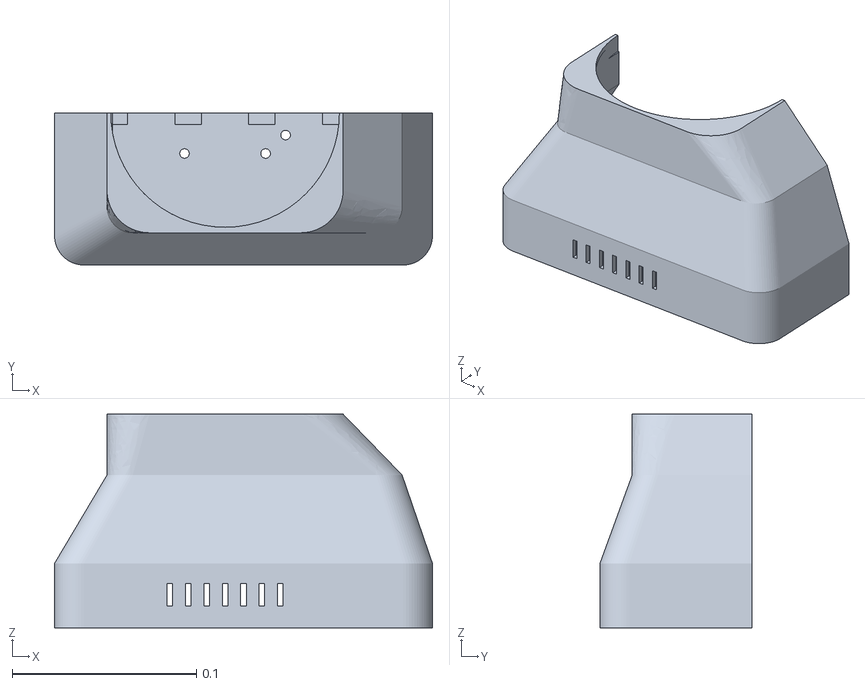
[picture p112: CAD file, 2026-10-20]
simulation/assets/E01.stl
0.205 x 0.0825 x 0.116
