Renanuya/optik-platform/cad/P16.step

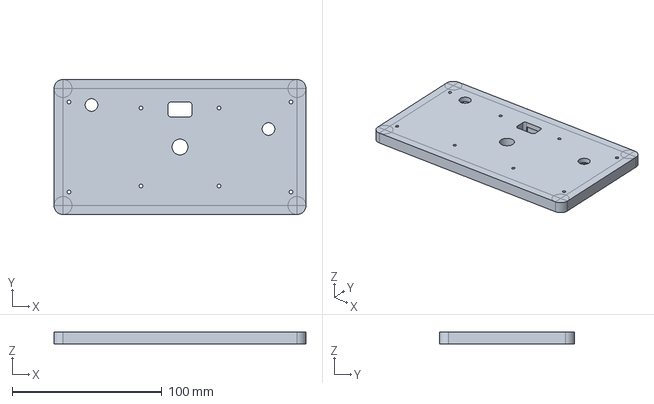
[picture p113: CAD file, 2026-10-20]
cad/P16.step
168.0 x 90.0 x 8.00 mm
