Renanuya/optik-platform/simulation/assets/P01.stl

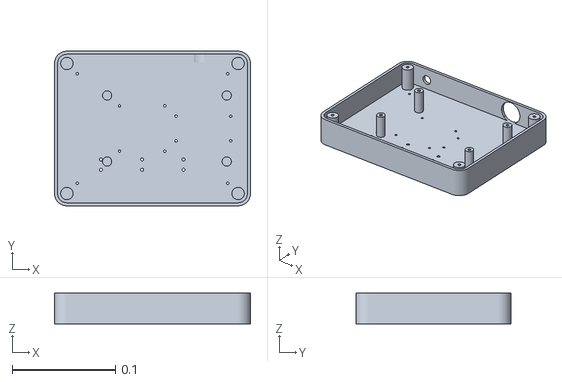
[picture p114: CAD file, 2026-10-20]
simulation/assets/P01.stl
0.19 x 0.15 x 0.03
