Renanuya/optik-platform/cad/P25.step

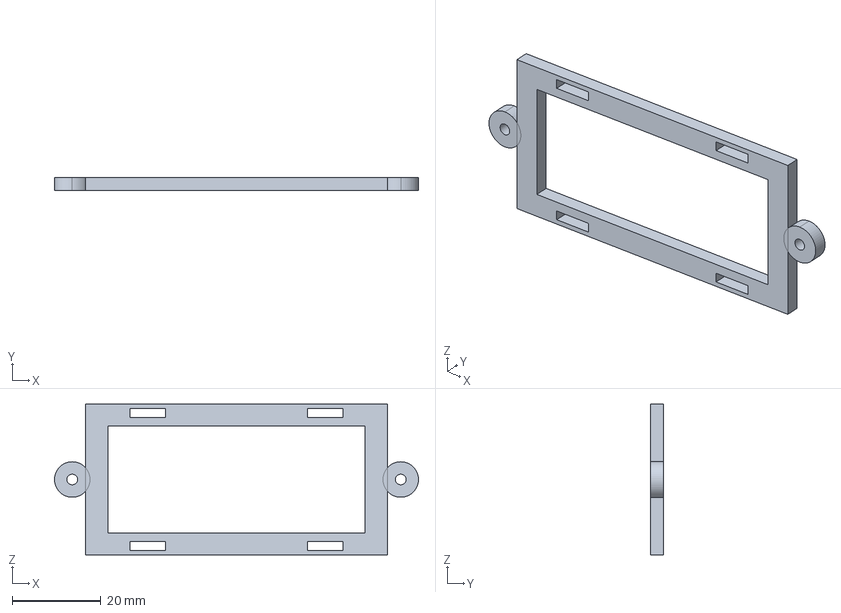
[picture p115: CAD file, 2026-10-20]
cad/P25.step
82.0 x 3.00 x 34.0 mm
