Renanuya/optik-platform/simulation/assets/E06.stl

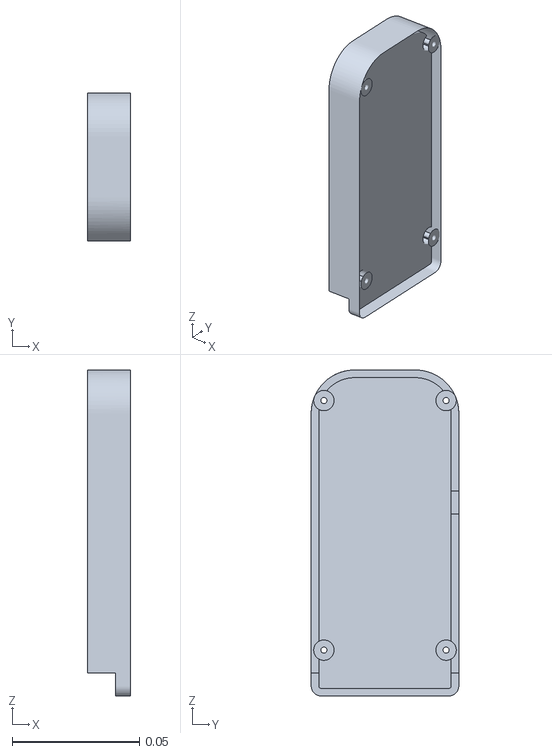
[picture p116: CAD file, 2026-10-20]
simulation/assets/E06.stl
0.017 x 0.058 x 0.128
