Renanuya/optik-platform/cad/P12.step

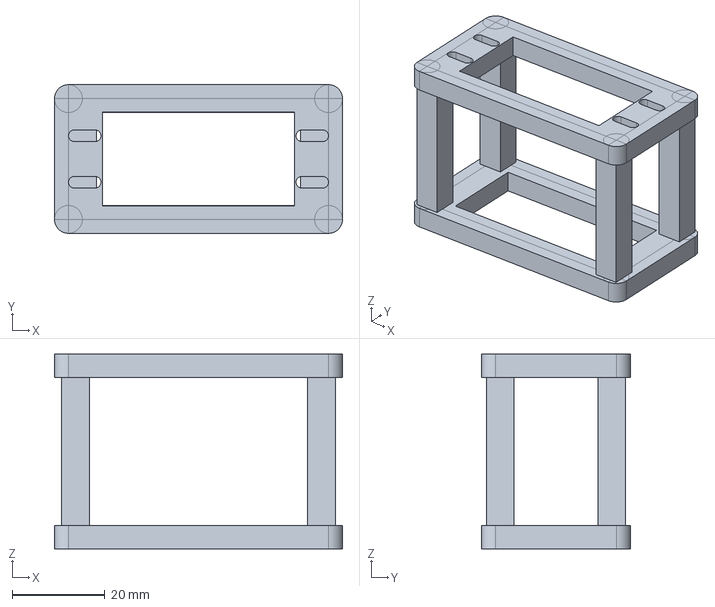
[picture p117: CAD file, 2026-10-20]
cad/P12.step
62.0 x 32.0 x 41.9 mm
