Renanuya/optik-platform/simulation/assets/P05.stl

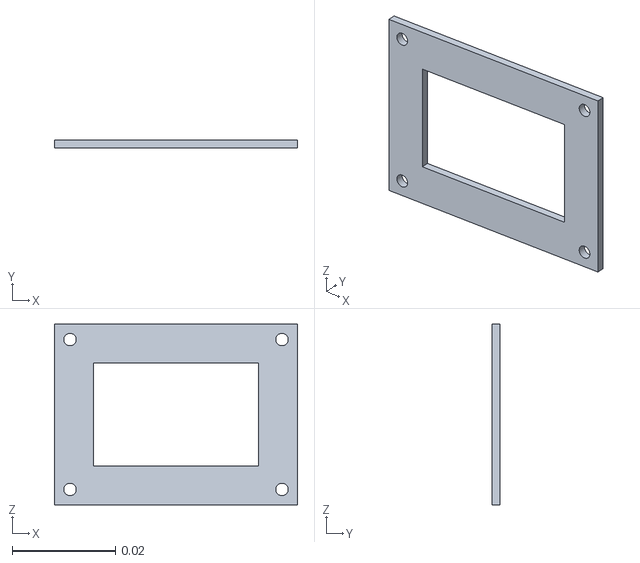
[picture p118: CAD file, 2026-10-20]
simulation/assets/P05.stl
0.047 x 0.0015 x 0.035
