Renanuya/optik-platform/simulation/assets/P04.stl

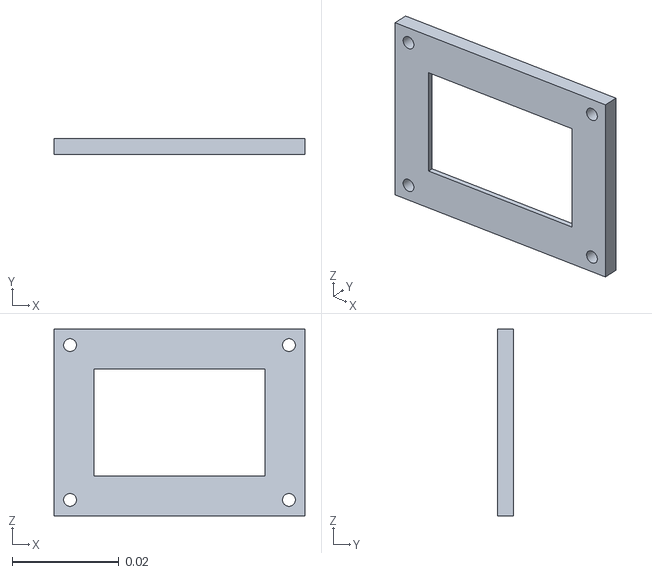
[picture p119: CAD file, 2026-10-20]
simulation/assets/P04.stl
0.047 x 0.003 x 0.035
