Renanuya/optik-platform/cad/E04.step

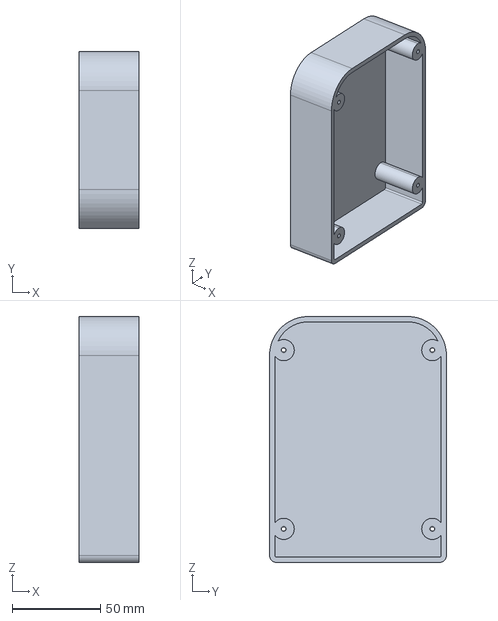
[picture p120: CAD file, 2026-10-20]
cad/E04.step
34.0 x 100.0 x 139.0 mm
