Renanuya/optik-platform/simulation/assets/P18.stl

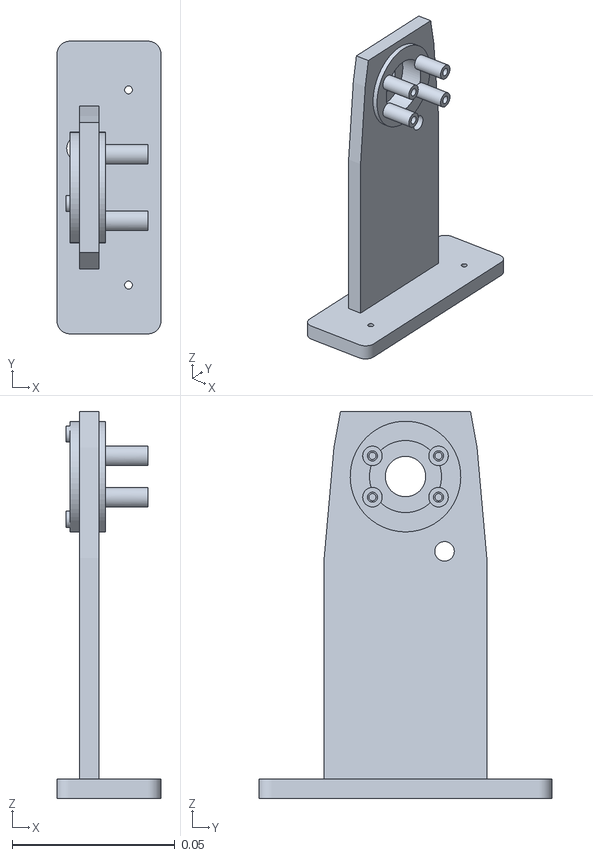
[picture p121: CAD file, 2026-10-20]
simulation/assets/P18.stl
0.032 x 0.09 x 0.119
