Renanuya/optik-platform/cad/P21.step

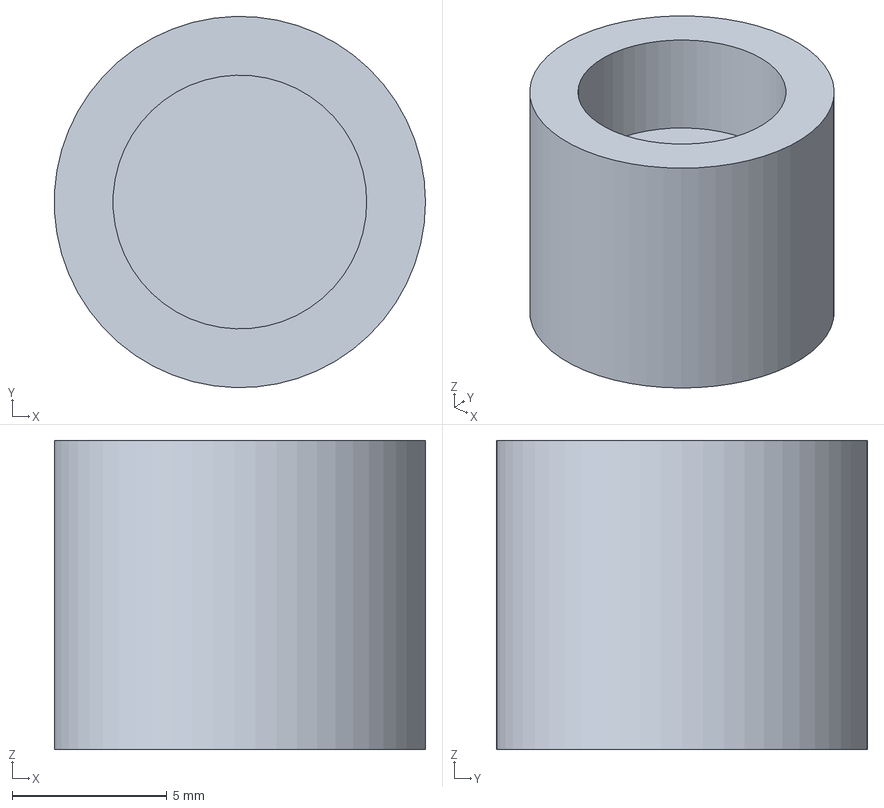
[picture p122: CAD file, 2026-10-20]
cad/P21.step
12.0 x 12.0 x 10.00 mm
