Renanuya/optik-platform/simulation/assets/P03.stl

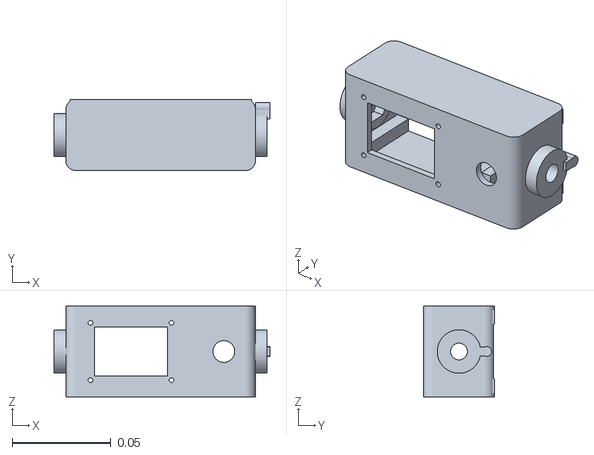
[picture p123: CAD file, 2026-10-20]
simulation/assets/P03.stl
0.109 x 0.036 x 0.046
