Renanuya/optik-platform/cad/E05.step

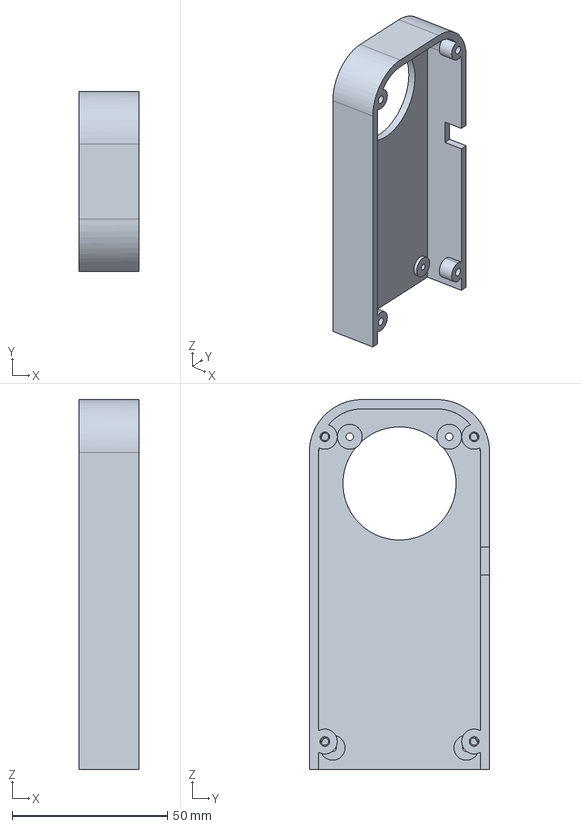
[picture p124: CAD file, 2026-10-20]
cad/E05.step
19.4 x 58.0 x 119.0 mm
