Renanuya/optik-platform/simulation/assets/P09.stl

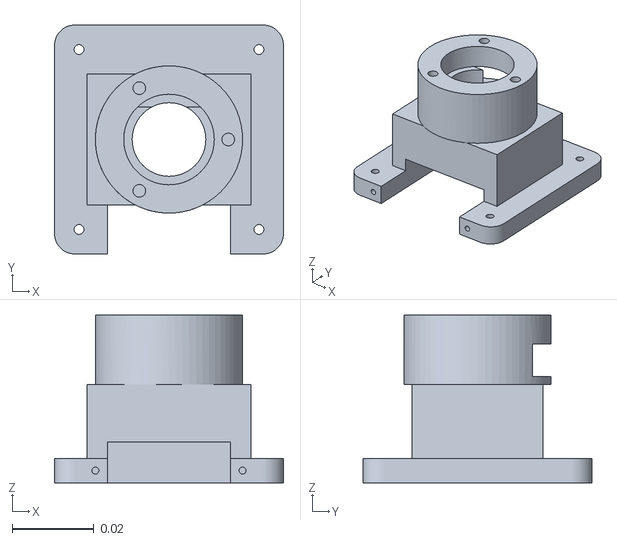
[picture p125: CAD file, 2026-10-20]
simulation/assets/P09.stl
0.056 x 0.056 x 0.041
