Renanuya/optik-platform/cad/P11.step

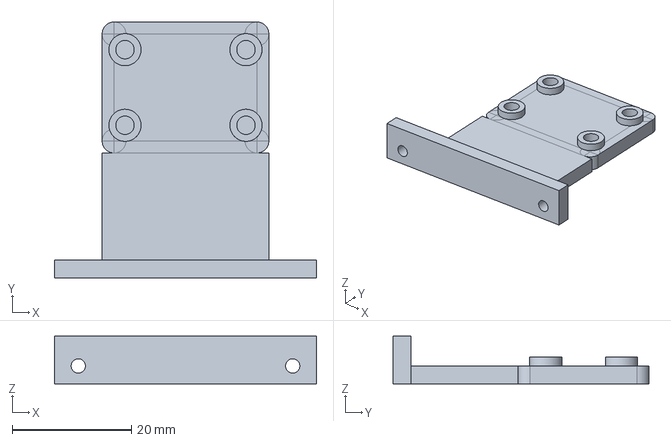
[picture p126: CAD file, 2026-10-20]
cad/P11.step
44.0 x 43.0 x 8.00 mm
