Renanuya/optik-platform/simulation/assets/P21.stl

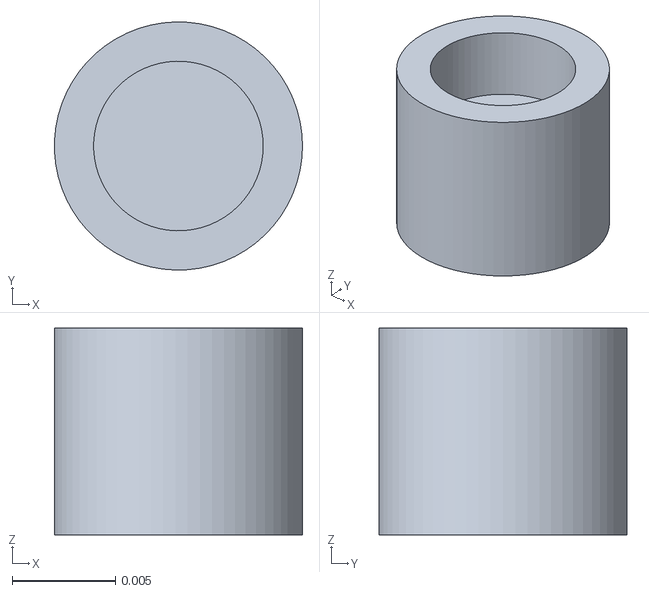
[picture p127: CAD file, 2026-10-20]
simulation/assets/P21.stl
0.012 x 0.012 x 0.01
