Renanuya/optik-platform/cad/P04.step

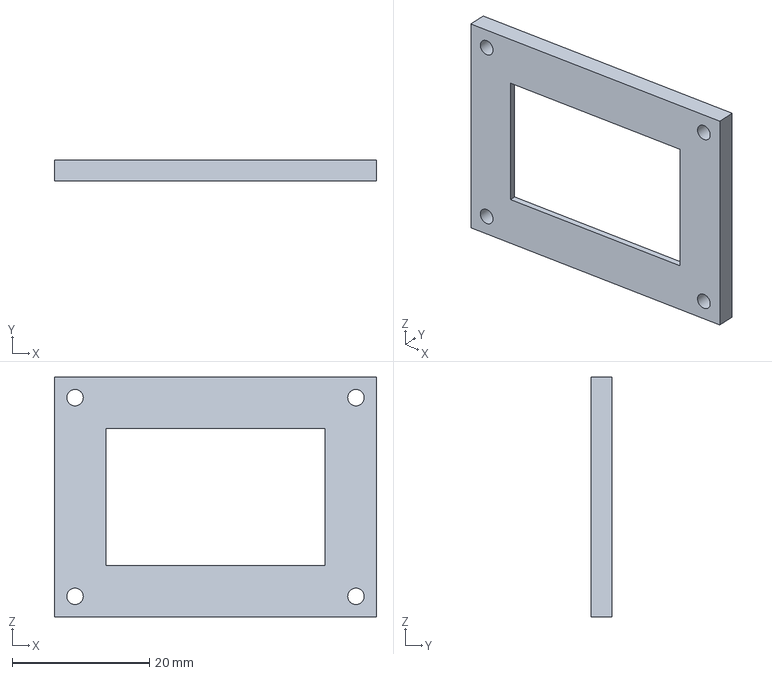
[picture p128: CAD file, 2026-10-20]
cad/P04.step
47.0 x 3.00 x 35.0 mm
