Renanuya/optik-platform/simulation/assets/P08.stl

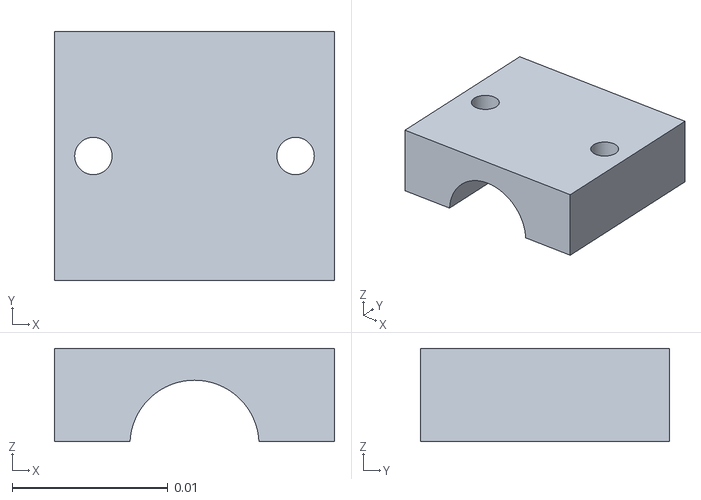
[picture p129: CAD file, 2026-10-20]
simulation/assets/P08.stl
0.018 x 0.016 x 0.006
