Renanuya/optik-platform/cad/P17.step

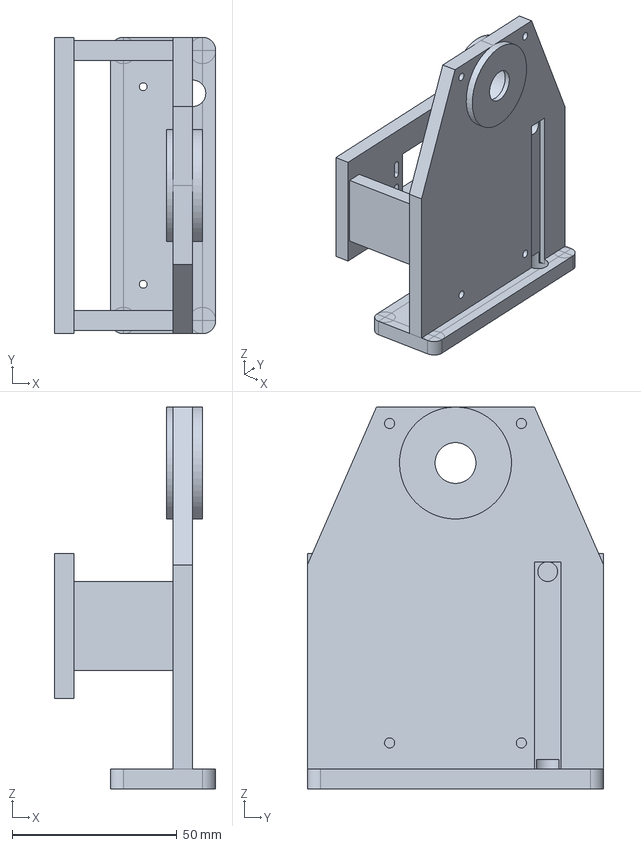
[picture p130: CAD file, 2026-10-20]
cad/P17.step
49.0 x 90.0 x 116.0 mm
