Renanuya/optik-platform/simulation/assets/E05.stl

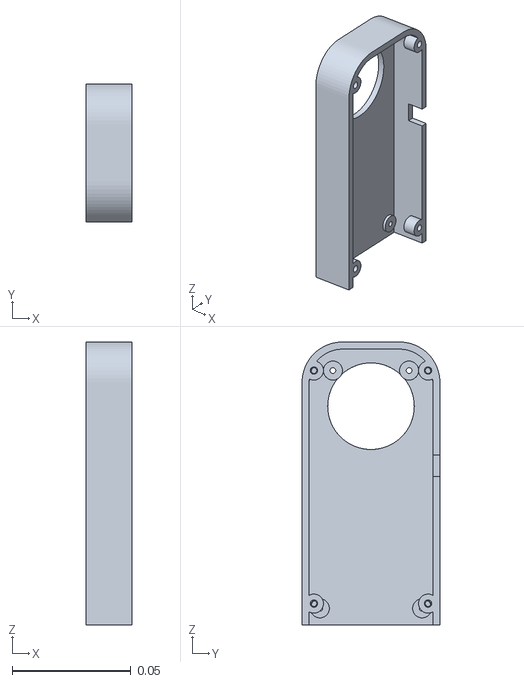
[picture p131: CAD file, 2026-10-20]
simulation/assets/E05.stl
0.0194 x 0.058 x 0.119
