Renanuya/optik-platform/cad/P26.step

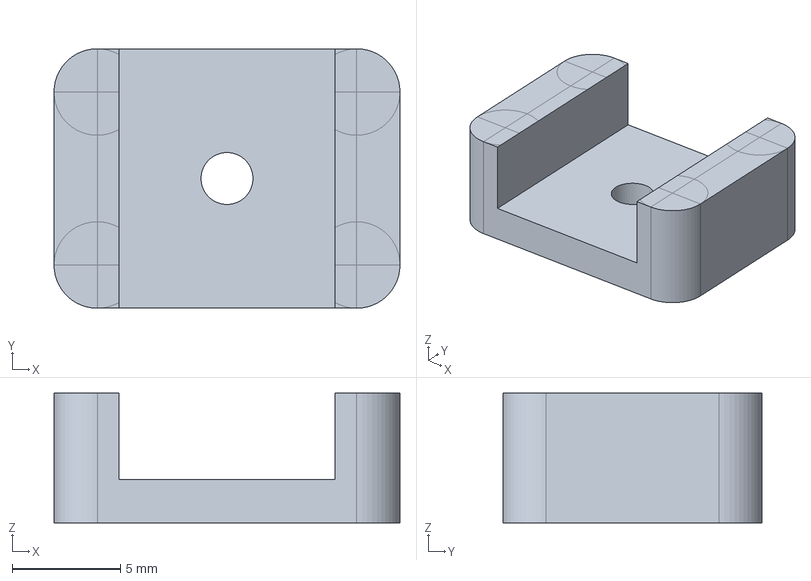
[picture p132: CAD file, 2026-10-20]
cad/P26.step
16.0 x 12.0 x 6.00 mm
