Renanuya/optik-platform/simulation/assets/P13.stl

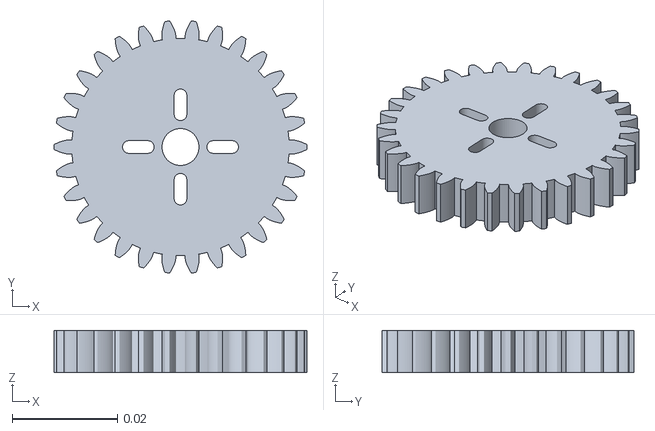
[picture p133: CAD file, 2026-10-20]
simulation/assets/P13.stl
0.048 x 0.0478 x 0.008
