Renanuya/optik-platform/cad/P18.step

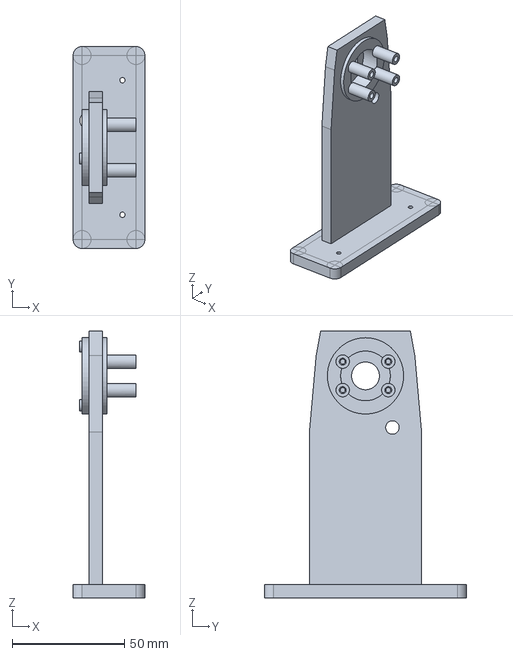
[picture p134: CAD file, 2026-10-20]
cad/P18.step
32.0 x 90.0 x 119.0 mm
