Renanuya/optik-platform/simulation/assets/P06.stl

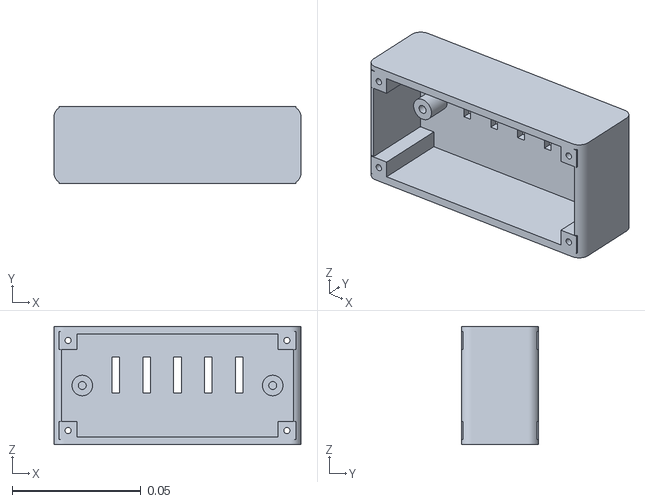
[picture p135: CAD file, 2026-10-20]
simulation/assets/P06.stl
0.096 x 0.03 x 0.046
