Renanuya/optik-platform/cad/P10.step

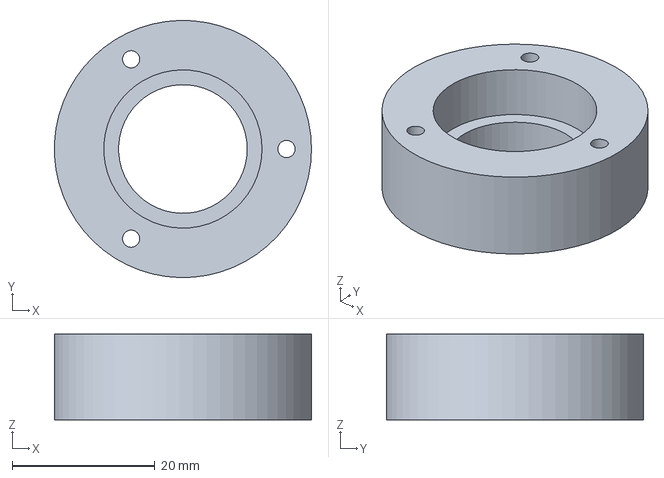
[picture p136: CAD file, 2026-10-20]
cad/P10.step
36.0 x 36.0 x 12.0 mm
