Renanuya/optik-platform/simulation/assets/P12.stl

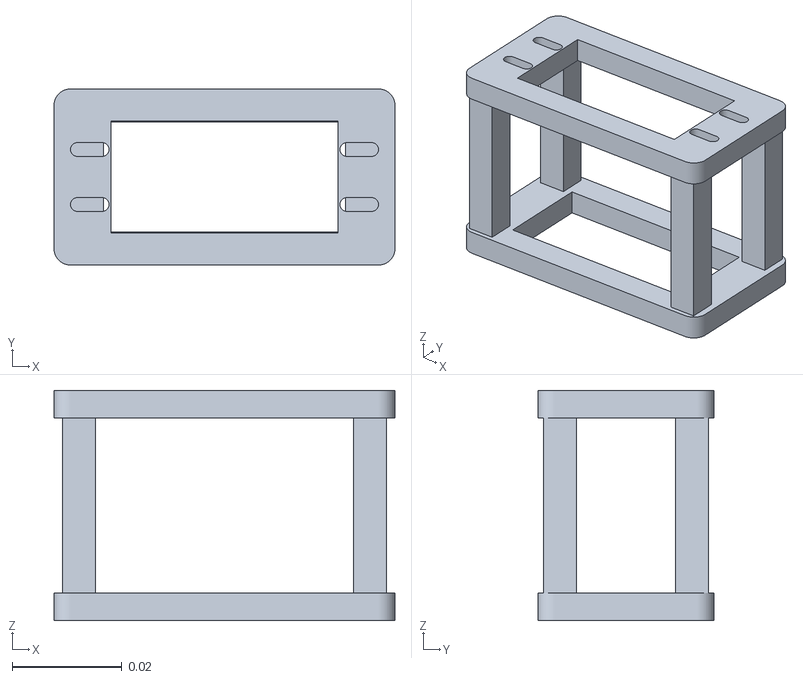
[picture p137: CAD file, 2026-10-20]
simulation/assets/P12.stl
0.062 x 0.032 x 0.0419
