Renanuya/optik-platform/cad/P02.step

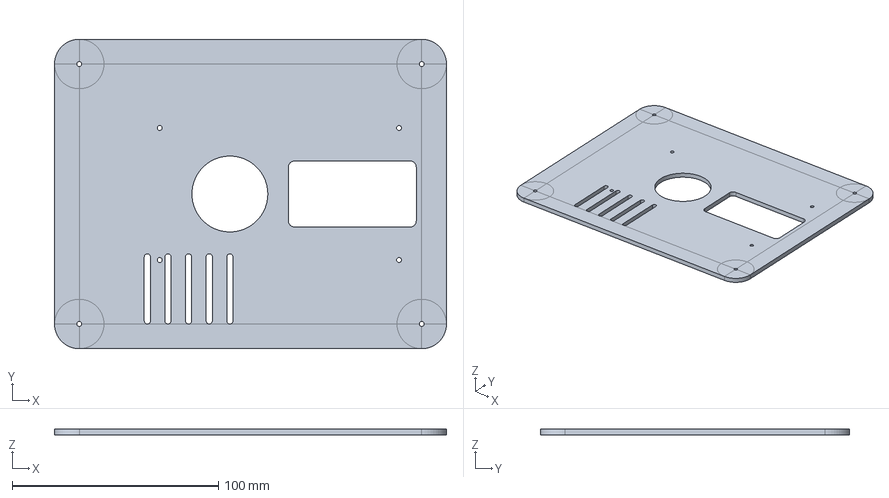
[picture p138: CAD file, 2026-10-20]
cad/P02.step
190.0 x 150.0 x 3.00 mm
