Renanuya/optik-platform/simulation/assets/P22.stl

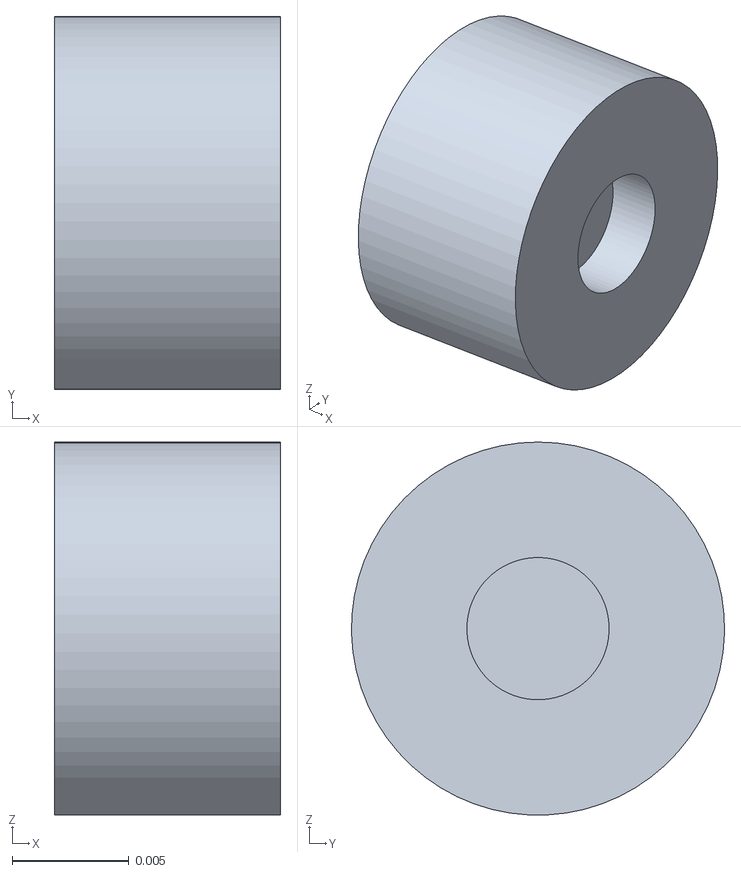
[picture p139: CAD file, 2026-10-20]
simulation/assets/P22.stl
0.0097 x 0.016 x 0.016
