Renanuya/optik-platform/cad/P19.step

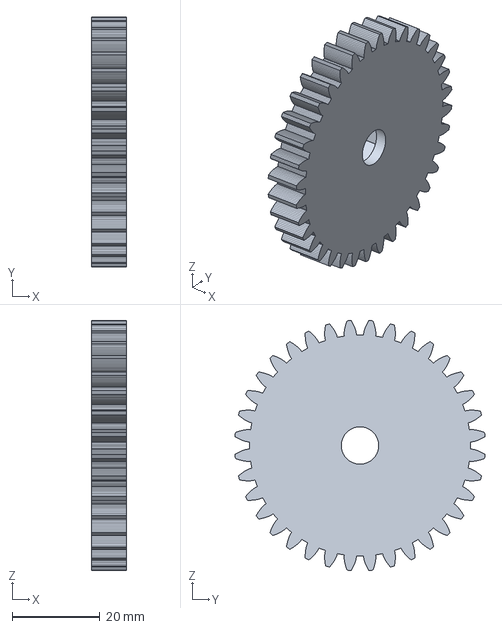
[picture p140: CAD file, 2026-10-20]
cad/P19.step
8.00 x 56.9 x 56.9 mm
