Renanuya/optik-platform/cad/P01.step

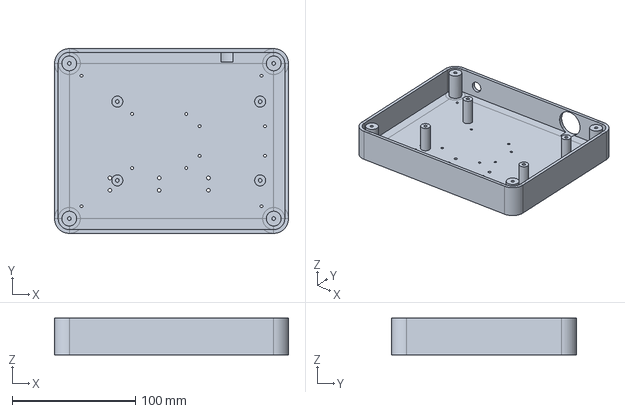
[picture p141: CAD file, 2026-10-20]
cad/P01.step
190.0 x 150.0 x 30.0 mm
