Renanuya/optik-platform/simulation/assets/P16.stl

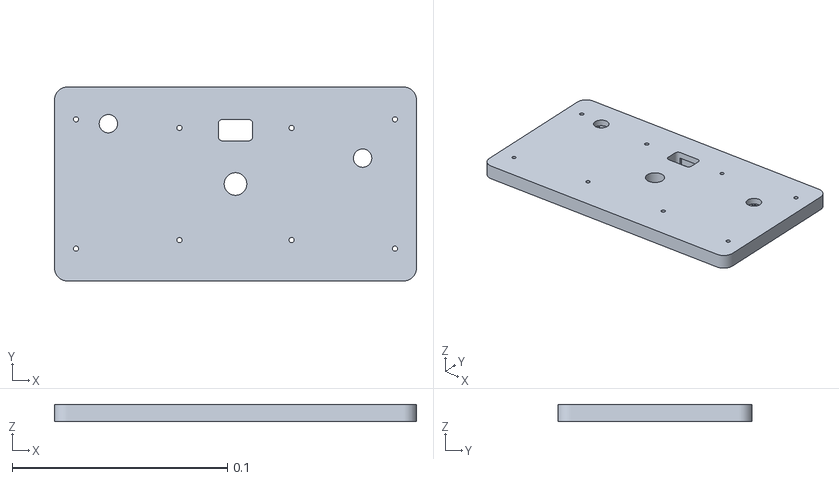
[picture p142: CAD file, 2026-10-20]
simulation/assets/P16.stl
0.168 x 0.09 x 0.008
