Renanuya/optik-platform/cad/E06.step

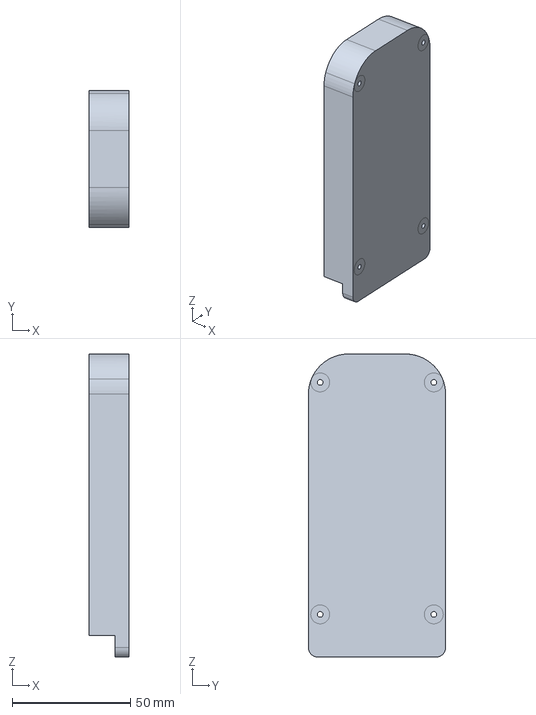
[picture p143: CAD file, 2026-10-20]
cad/E06.step
17.0 x 58.0 x 128.0 mm
