Renanuya/optik-platform/cad/E01.step

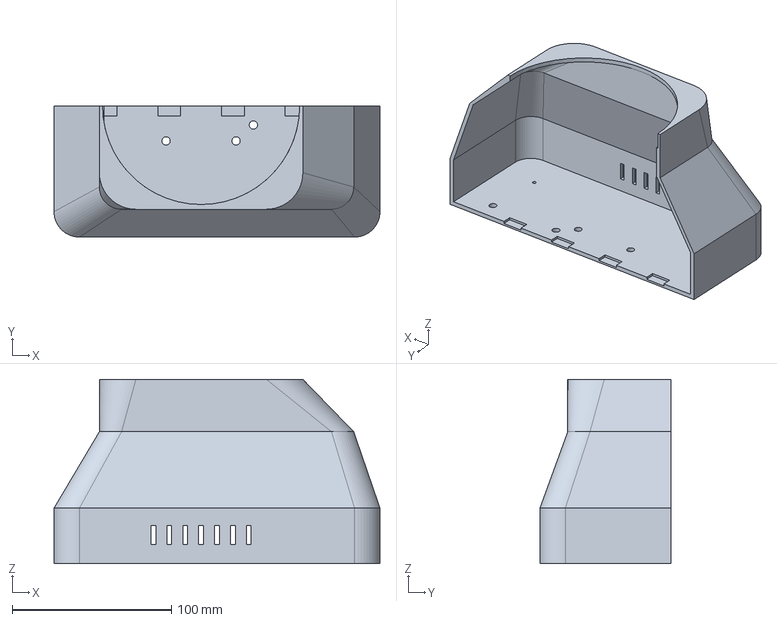
[picture p144: CAD file, 2026-10-20]
cad/E01.step
205.0 x 82.5 x 116.0 mm
