Renanuya/optik-platform/simulation/assets/P11.stl

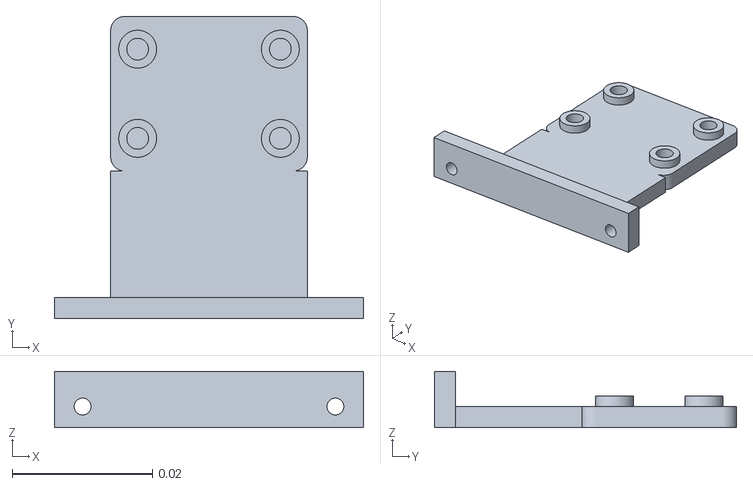
[picture p145: CAD file, 2026-10-20]
simulation/assets/P11.stl
0.044 x 0.043 x 0.008
