Renanuya/optik-platform/cad/P15.step

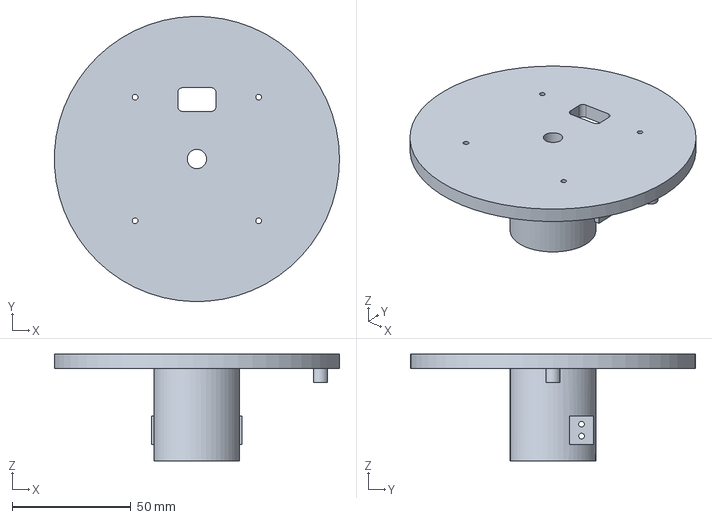
[picture p146: CAD file, 2026-10-20]
cad/P15.step
119.9 x 120.0 x 45.0 mm
