Renanuya/optik-platform/simulation/assets/E03.stl

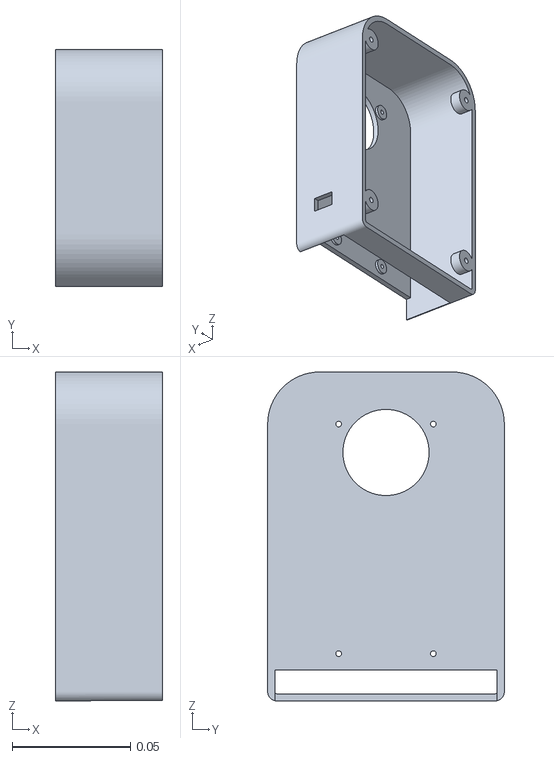
[picture p147: CAD file, 2026-10-20]
simulation/assets/E03.stl
0.0454 x 0.1 x 0.139
