Renanuya/optik-platform/cad/P22.step

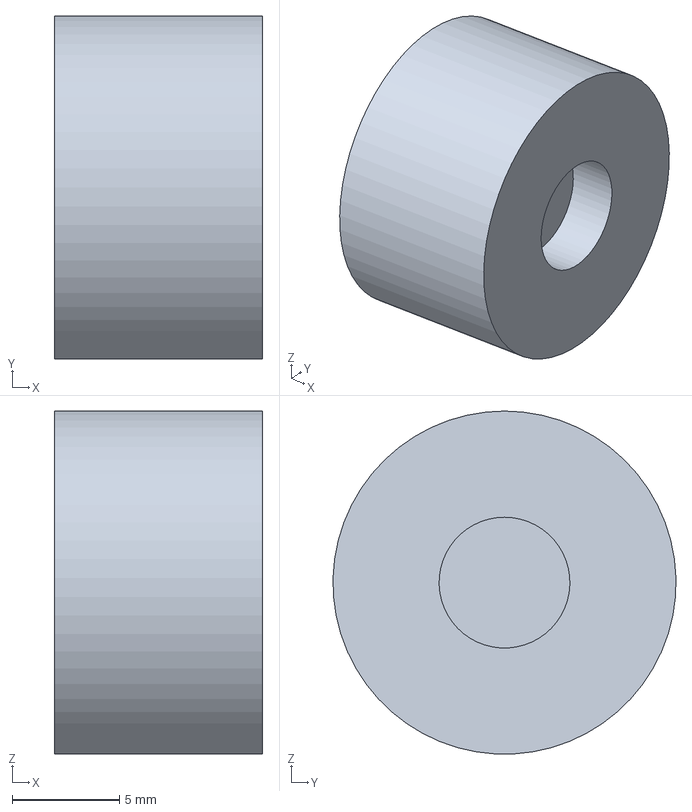
[picture p148: CAD file, 2026-10-20]
cad/P22.step
9.70 x 16.0 x 16.0 mm
