Renanuya/optik-platform/simulation/assets/P02.stl

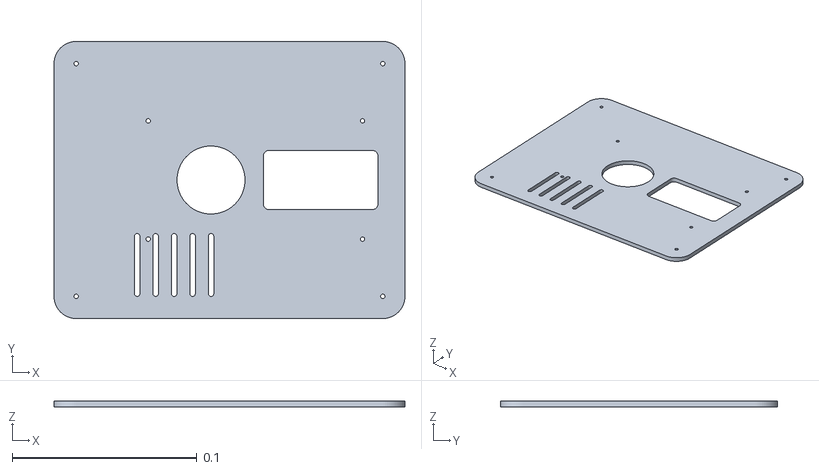
[picture p149: CAD file, 2026-10-20]
simulation/assets/P02.stl
0.19 x 0.15 x 0.003
