Renanuya/optik-platform/simulation/assets/P25.stl

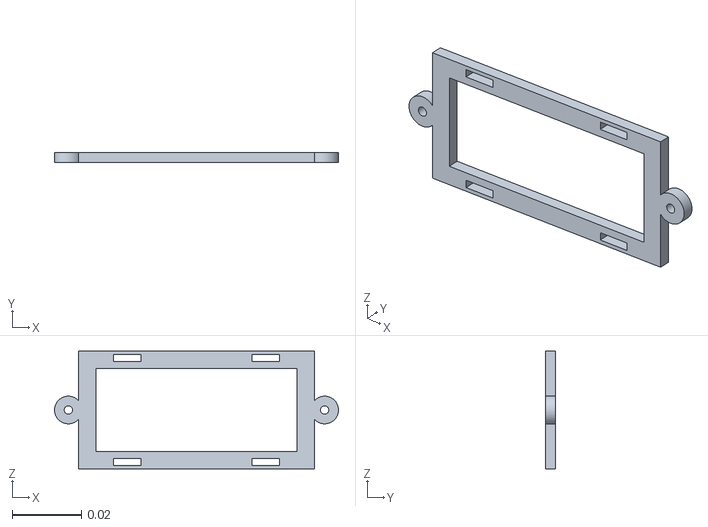
[picture p150: CAD file, 2026-10-20]
simulation/assets/P25.stl
0.082 x 0.003 x 0.034
