Renanuya/optik-platform/cad/P24.step

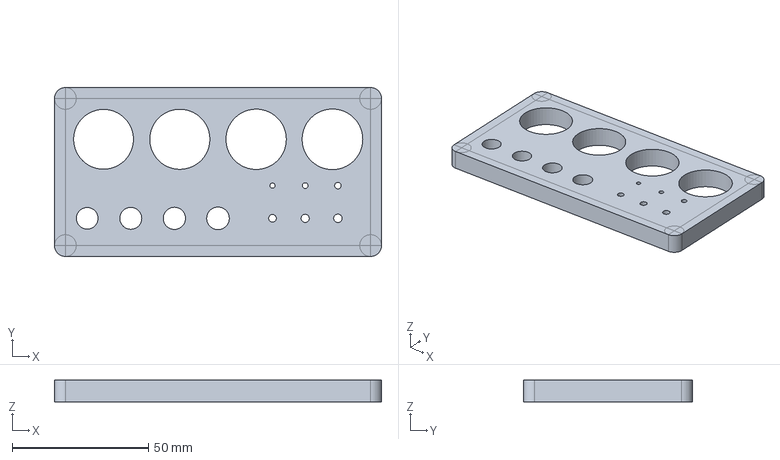
[picture p151: CAD file, 2026-10-20]
cad/P24.step
120.0 x 62.0 x 8.00 mm
