Renanuya/optik-platform/simulation/assets/P20.stl

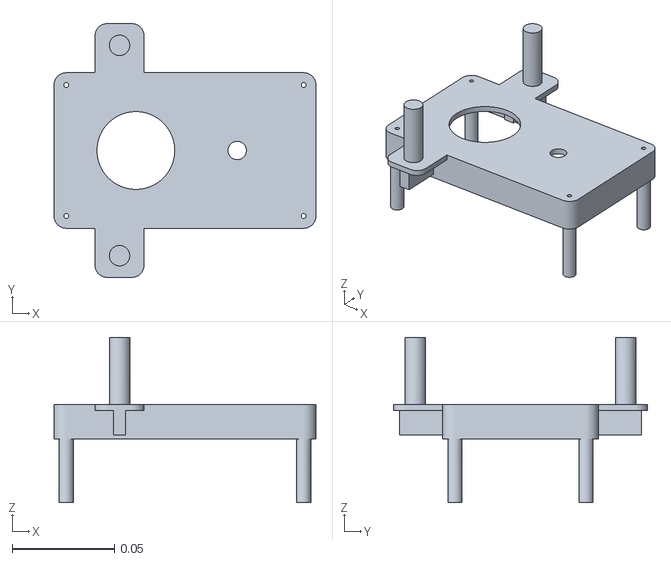
[picture p152: CAD file, 2026-10-20]
simulation/assets/P20.stl
0.128 x 0.124 x 0.0807
