Renanuya/optik-platform/cad/E02.step

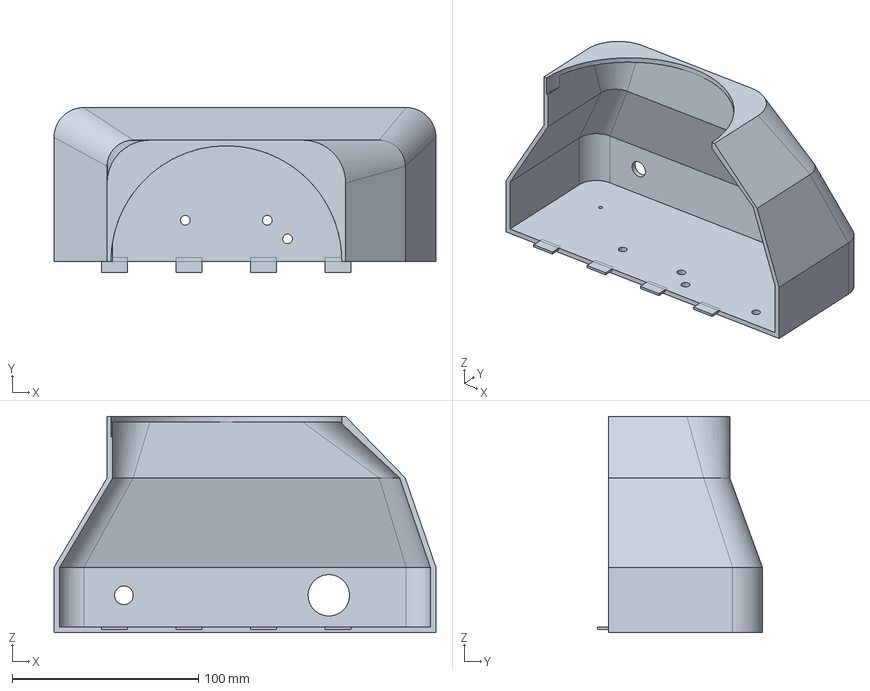
[picture p153: CAD file, 2026-10-20]
cad/E02.step
205.0 x 88.5 x 116.0 mm
