Renanuya/optik-platform/cad/P13.step

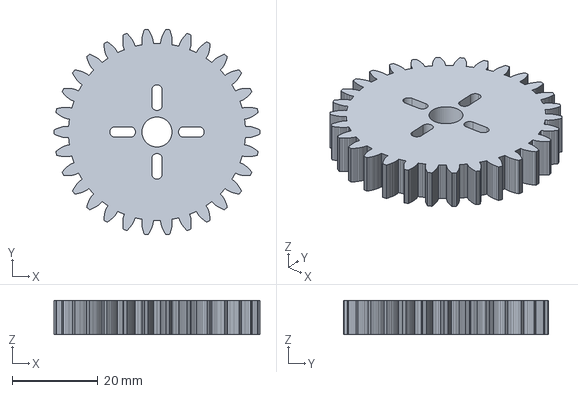
[picture p154: CAD file, 2026-10-20]
cad/P13.step
48.0 x 47.8 x 8.00 mm
