Renanuya/optik-platform/simulation/assets/E02.stl

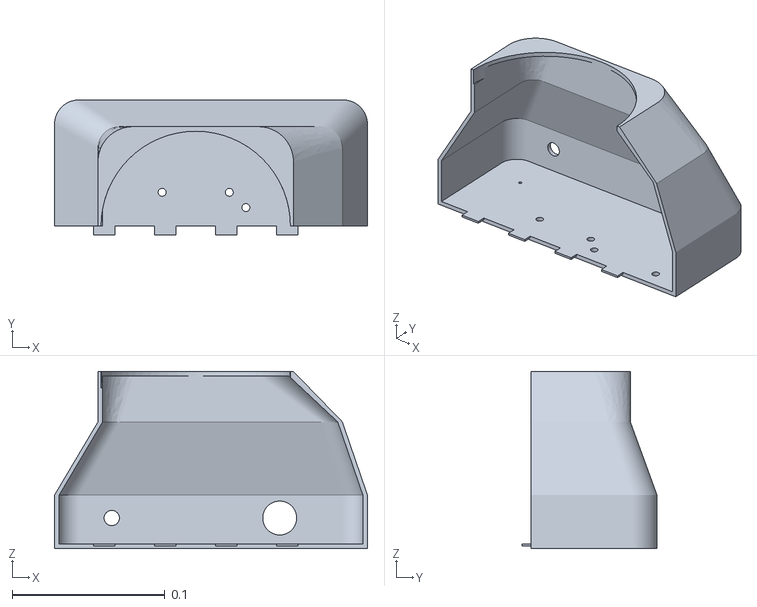
[picture p155: CAD file, 2026-10-20]
simulation/assets/E02.stl
0.205 x 0.0885 x 0.116
