Renanuya/optik-platform/cad/E03.step

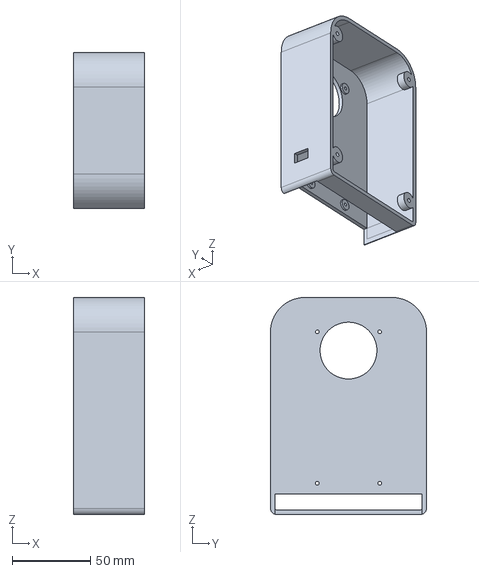
[picture p156: CAD file, 2026-10-20]
cad/E03.step
45.4 x 100.0 x 139.0 mm
