Renanuya/optik-platform/(list of files, cad)

Other CAD files:
cad/P07.step
simulation/assets/P19.stl
simulation/assets/P07.stl
cad/P14.step
simulation/assets/P13b.stl
stl/E01.stl
stl/E02.stl
stl/E03.stl
stl/E04.stl
stl/E05.stl
stl/E06.stl
stl/P01.stl
stl/P02.stl
stl/P03.stl
stl/P04.stl
stl/P05.stl
stl/P06.stl
stl/P07.stl
stl/P08.stl
stl/P09.stl
stl/P10.stl
stl/P11.stl
stl/P12.stl
stl/P13.stl
stl/P14.stl
stl/P15.stl
stl/P16.stl
stl/P17.stl
stl/P18.stl
stl/P19.stl
stl/P20.stl
stl/P21.stl
stl/P22.stl
stl/P23.stl
stl/P24.stl
stl/P25.stl
stl/P26.stl
