Renanuya/optik-platform/(commit log)

2026-10-20 Add optical platform prototype CAD and part gallery
    [OPTIK-montaj.step, P01.step, P01.stl, P02.step, P02.stl, P03.step, P03.stl, P04.step]
2026-10-20 Prepare R0.2 enclosures, M2 assembly, drawings and MuJoCo build
2026-10-20 Check M2 engagement lengths and orient electronics lid for printing
2026-10-20 Deliver R0.2 validated CAD, 38-page drawings and MuJoCo motion videos
    [BOM.csv, E01.step, E01.stl, E02.step, E02.stl, E03.step, E03.stl, E04.step]
